icl-rocketry/Ricardo-ThrottleController/README.md

# C.H.A.D - Servo Control Board
2 servo channels controlled by PWM, with a buck converter set to output 6V or 8.4V @ 12A depending on configuration.
