icl-rocketry/Ricardo-ThrottleController/Hardware/3D/Chad.step

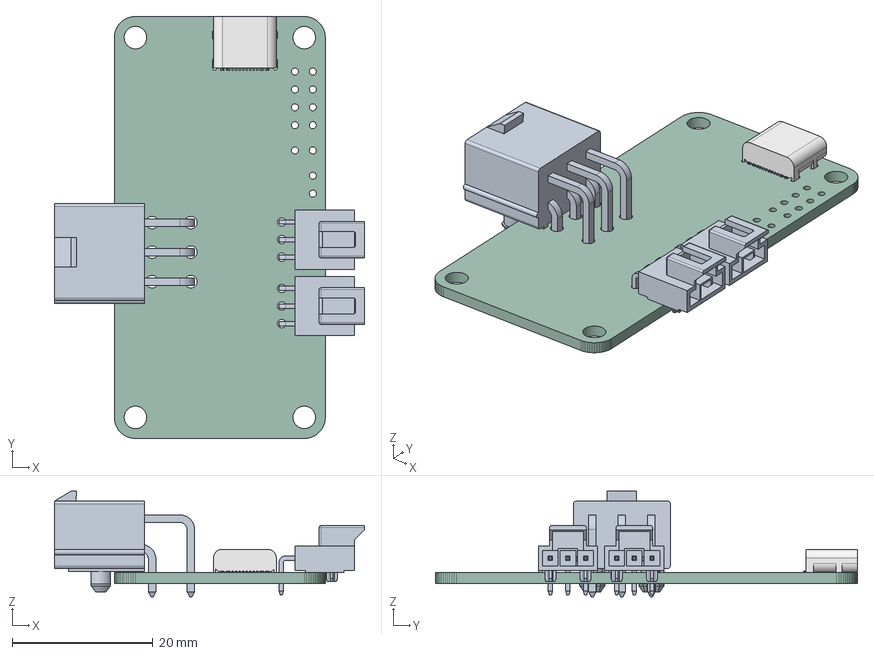
[picture p1: CAD file, 2023-02-25, last stored version]
Hardware/3D/Chad.step
44.1 x 60.0 x 15.0 mm
PCB
