icl-rocketry/Ricardo-ThrottleController/Hardware/Chad.kicad_pcb

## KiCad design Hardware/Chad.kicad_pcb (2023-07-09, last stored version)

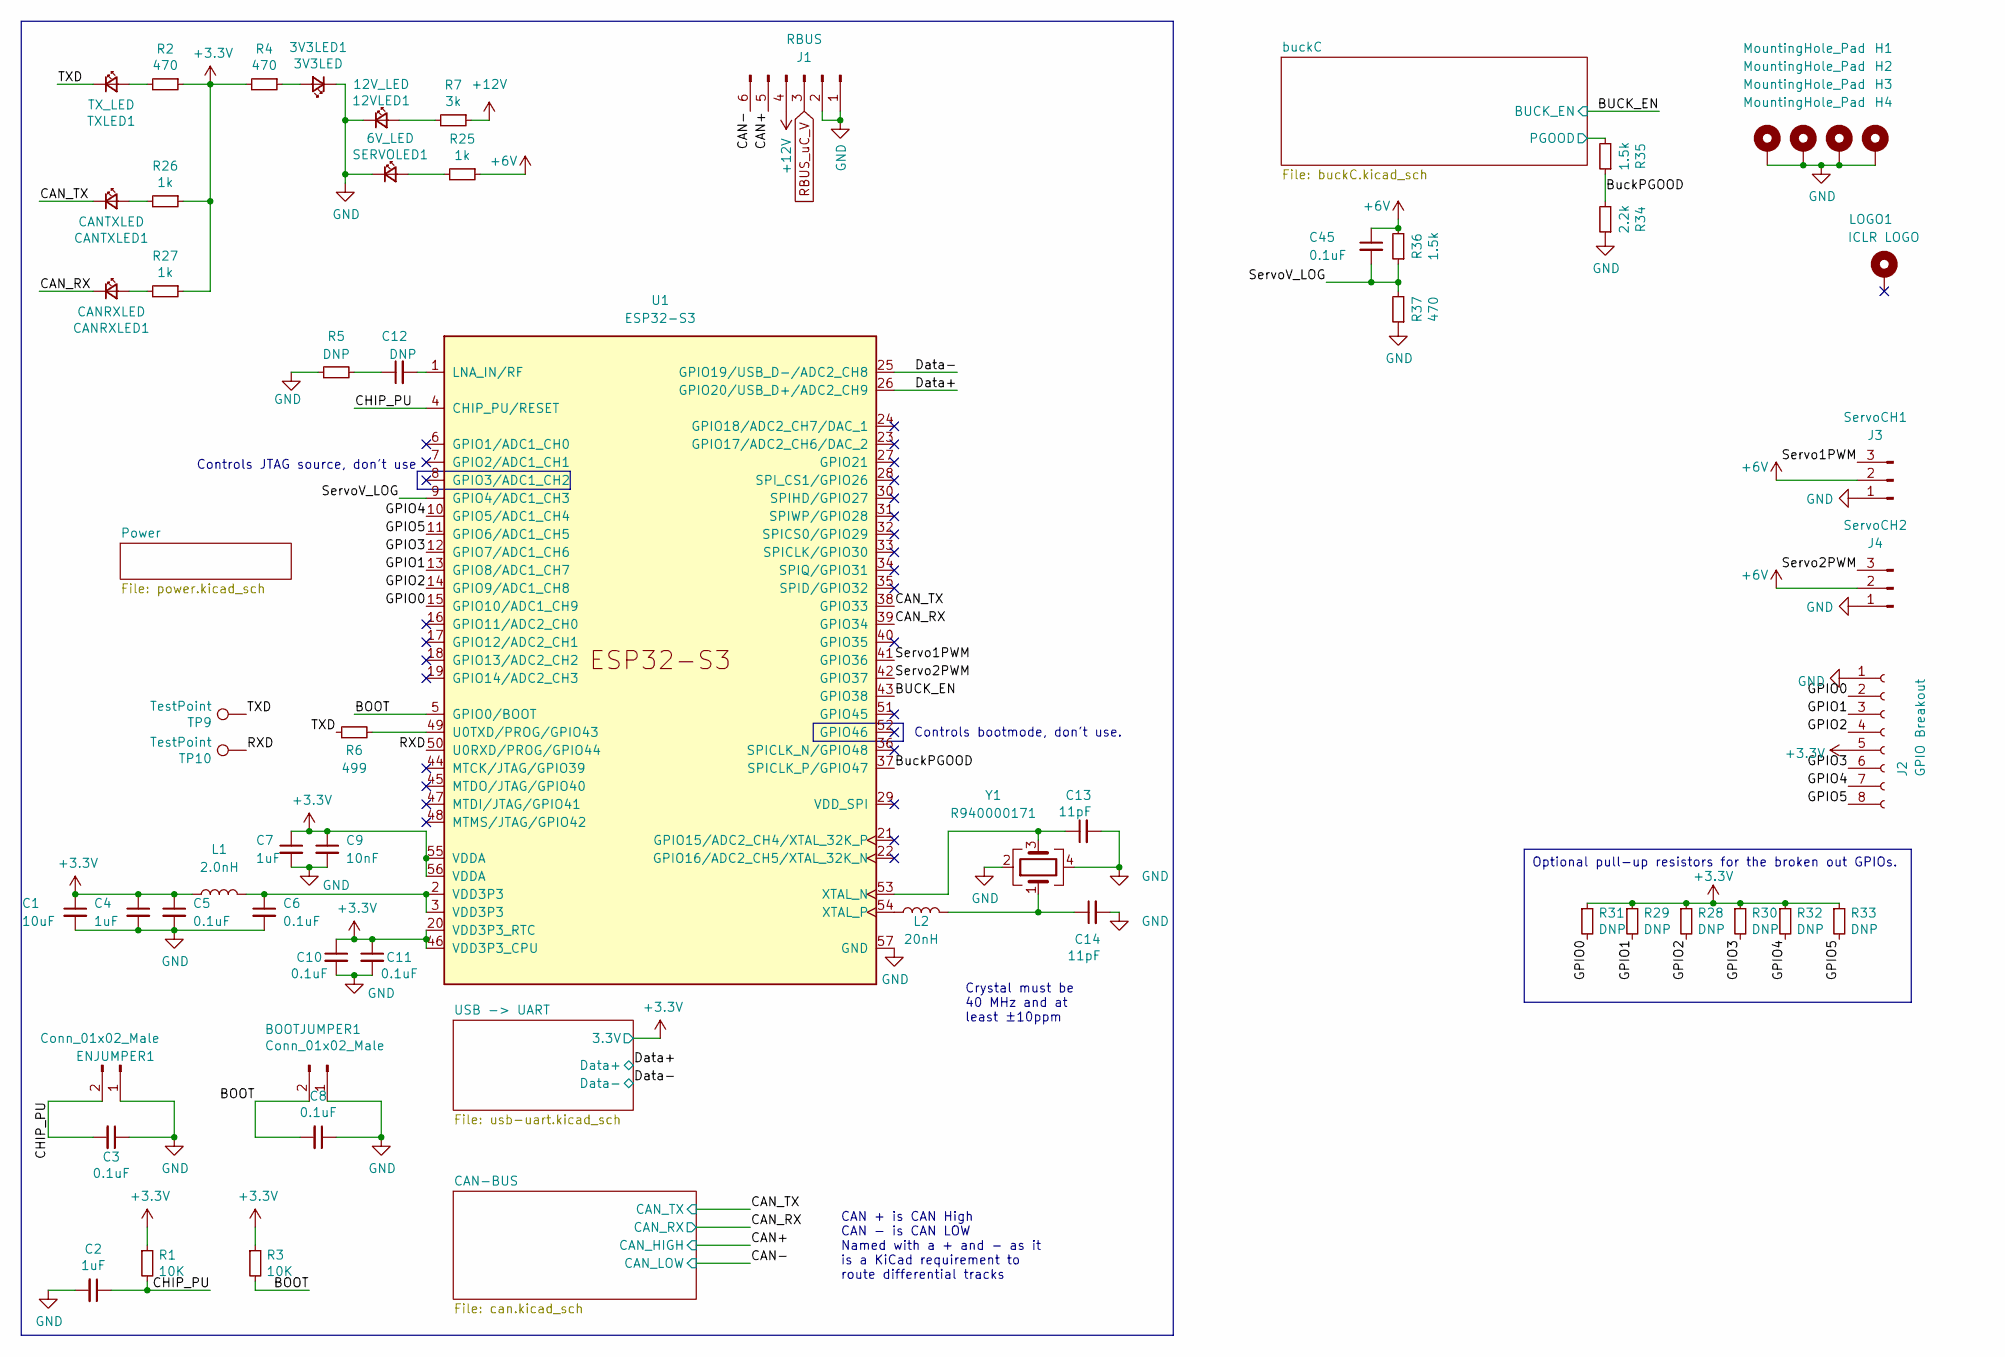
[picture p2: schematic Chad.kicad_sch, C.H.A.D]

Parts:
3V3LED1: 3V3LED; LED_0402_1005Metric
12VLED1: 12V_LED; LED_0402_1005Metric
BOOTJUMPER1: Conn_01x02_Male; PinHeader_1x02_P2.54mm_Vertical
C1: 10uF; C_0402_1005Metric
C2, C4, C7: 1uF; C_0402_1005Metric
C3, C5, C6, C8, C10, C11, C45: 0.1uF; C_0402_1005Metric
C9: 10nF; C_0402_1005Metric
C12: DNP; C_0402_1005Metric
C13, C14: 11pF; C_0402_1005Metric
CANRXLED1: CANRXLED; LED_0402_1005Metric
CANTXLED1: CANTXLED; LED_0402_1005Metric
ENJUMPER1: Conn_01x02_Male; PinHeader_1x02_P2.54mm_Vertical
H1, H2, H3, H4: MountingHole_Pad; MountingHole_3.2mm_M3_DIN965_Pad
J1: RBUS; Molex_Mini-Fit_Jr_5569-06A2_2x03_P4.20mm_Horizontal
J2: GPIO Breakout; PinSocket_2x04_P2.54mm_Vertical
J3: ServoCH1; Molex_Nano-Fit_105313-xx03_1x03_P2.50mm_Horizontal
J4: ServoCH2; Molex_Nano-Fit_105313-xx03_1x03_P2.50mm_Horizontal
L1: 2.0nH; L_0402_1005Metric
L2: 20nH; L_0402_1005Metric
LOGO1: ICLR LOGO; iclr_logo_estd2018_10mm
R1, R3: 10K; R_0402_1005Metric
R2, R4, R37: 470; R_0402_1005Metric
R5, R28, R29, R30, R31, R32, R33: DNP; R_0402_1005Metric
R6: 499; R_0402_1005Metric
R7: 3k; R_0402_1005Metric
R25, R26, R27: 1k; R_0402_1005Metric
R34: 2.2k; R_0402_1005Metric
R35, R36: 1.5k; R_0402_1005Metric
SERVOLED1: 6V_LED; LED_0402_1005Metric
TP9, TP10: TestPoint; TestPoint_Pad_D1.0mm
TXLED1: TX_LED; LED_0402_1005Metric
U1: ESP32-S3; QFN40P700X700X90-57N
Y1: R940000171; Crystal_SMD_2016-4Pin_2.0x1.6mm

Connections:
+3V3: C1.1, C4.1, C5.1, C7.1, C9.1, C10.1, C11.1, J2.5, L1.1, R1.1, R2.1, R3.1, R4.2, R26.1, R27.1, R28.1, R29.1, R30.1, R31.1, R32.1, R33.1, U1.20 (VDD3P3_RTC), U1.46 (VDD3P3_CPU), U1.55 (VDDA), U1.56 (VDDA); also elsewhere on the board
+6V: C45.1, J3.2, J4.2, R25.1, R36.2; also elsewhere on the board
+12V: J1.4, R7.1; also elsewhere on the board
/BOOT: BOOTJUMPER1.2, C8.2, R3.2, U1.5 (GPIO0/BOOT)
/BUCK_EN: U1.43 (GPIO38); also elsewhere on the board
/BuckPGOOD: R34.2, R35.1, U1.37 (SPICLK_P/GPIO47)
/CAN+: J1.5; also elsewhere on the board
/CAN-: J1.6; also elsewhere on the board
/CAN_RX: CANRXLED1.1 (K), U1.39 (GPIO34); also elsewhere on the board
/CAN_TX: CANTXLED1.1 (K), U1.38 (GPIO33); also elsewhere on the board
/CHIP_PU: C2.1, C3.2, ENJUMPER1.2, R1.2, U1.4 (CHIP_PU/RESET)
/Data+: U1.26 (GPIO20/USB_D+/ADC2_CH9); also elsewhere on the board
/Data-: U1.25 (GPIO19/USB_D-/ADC2_CH8); also elsewhere on the board
/GPIO0: J2.2, R31.2, U1.15 (GPIO10/ADC1_CH9)
/GPIO1: J2.3, R29.2, U1.13 (GPIO8/ADC1_CH7)
/GPIO2: J2.4, R28.2, U1.14 (GPIO9/ADC1_CH8)
/GPIO3: J2.6, R30.2, U1.12 (GPIO7/ADC1_CH6)
/GPIO4: J2.7, R32.2, U1.10 (GPIO5/ADC1_CH4)
/GPIO5: J2.8, R33.2, U1.11 (GPIO6/ADC1_CH5)
/RXD: TP10.1, U1.50 (U0RXD/PROG/GPIO44)
/Servo1PWM: J3.3, U1.41 (GPIO36)
/Servo2PWM: J4.3, U1.42 (GPIO37)
/ServoV_LOG: C45.2, R36.1, R37.2, U1.9 (GPIO4/ADC1_CH3)
/TXD: R6.1, TP9.1, TXLED1.1 (K)
/buckC/PGOOD: R35.2; also elsewhere on the board
GND: 3V3LED1.1 (K), 12VLED1.1 (K), BOOTJUMPER1.1, C1.2, C2.2, C3.1, C4.2, C5.2, C6.2, C7.2, C8.1, C9.2, C10.2, C11.2, C13.2, C14.2, ENJUMPER1.1, H1.1, H2.1, H3.1, H4.1, J1.1, J1.2, J2.1, J3.1, J4.1, R5.1, R34.1, R37.1, SERVOLED1.1 (K), U1.57 (GND), Y1.2, Y1.4; also elsewhere on the board
unnamed: 3V3LED1.2 (A), R4.1
unnamed: 12VLED1.2 (A), R7.2
unnamed: C6.1, L1.2, U1.2 (VDD3P3), U1.3 (VDD3P3)
unnamed: C12.1, R5.2
unnamed: C14.1, L2.2, Y1.1
unnamed: CANRXLED1.2 (A), R27.2
unnamed: CANTXLED1.2 (A), R26.2
unnamed: R25.2, SERVOLED1.2 (A)
unnamed: R2.2, TXLED1.2 (A)
unnamed: C12.2, U1.1 (LNA_IN/RF)
unnamed: R6.2, U1.49 (U0TXD/PROG/GPIO43)
unnamed: C13.1, U1.53 (XTAL_N), Y1.3
unnamed: L2.1, U1.54 (XTAL_P)
RBUS_uC_V: J1.3; also elsewhere on the board

Notes on the sheet:
Crystal must be 40 MHz and at least ±10ppm
Optional pull-up resistors for the broken out GPIOs.
Controls bootmode, don't use.
CAN + is CAN High CAN - is CAN LOW Named with a + and - as it is a KiCad requirement to route differential tracks
Controls JTAG source, don't use

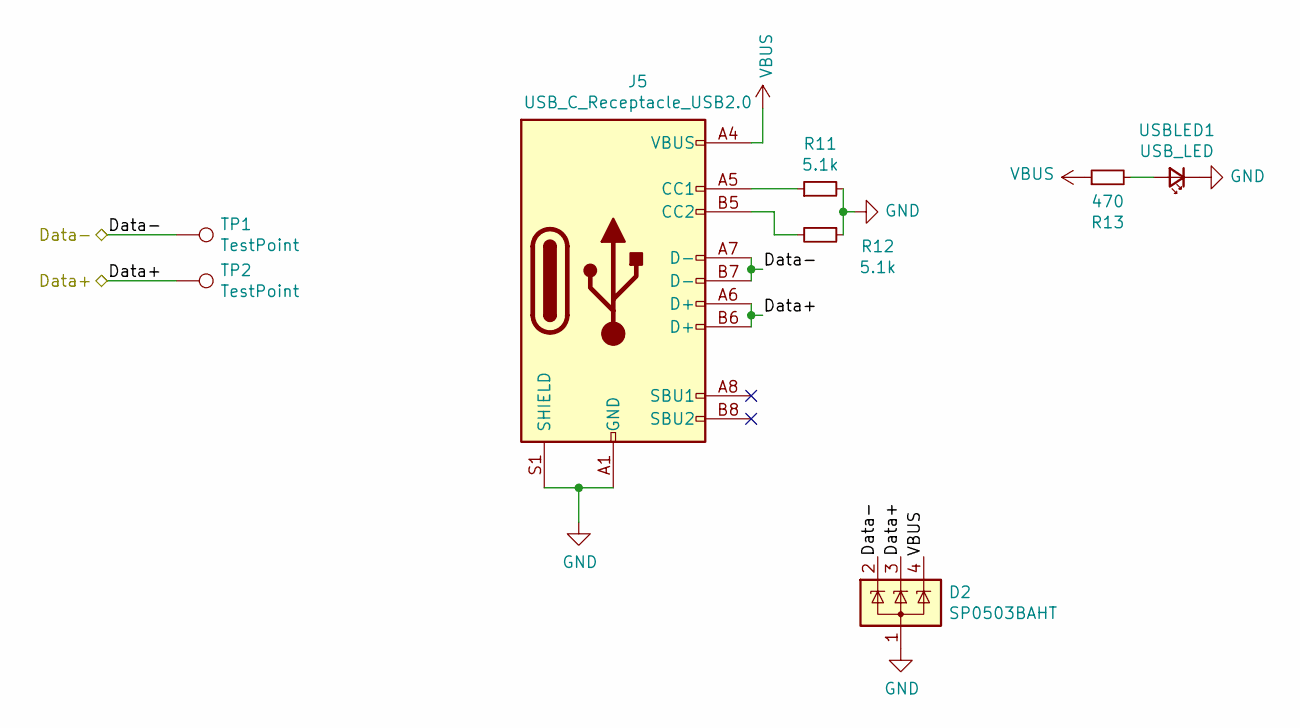
[picture p3: schematic usb-uart.kicad_sch]

Parts:
D2: SP0503BAHT; SOT-143
J5: USB_C_Receptacle_USB2.0; USB_C_Receptacle_Palconn_UTC16-G
R11, R12: 5.1k; R_0402_1005Metric
R13: 470; R_0402_1005Metric
TP1, TP2: TestPoint; TestPoint_Pad_D1.0mm
USBLED1: USB_LED; LED_0402_1005Metric

Connections:
/Data+: D2.3 (K), J5.A6 (D+), J5.B6 (D+), TP2.1; also elsewhere on the board
/Data-: D2.2 (K), J5.A7 (D-), J5.B7 (D-), TP1.1; also elsewhere on the board
GND: D2.1 (A), J5.A1 (GND), J5.A12 (GND), J5.B1 (GND), J5.B12 (GND), J5.S1 (SHIELD), R11.2, R12.1, USBLED1.1 (K); also elsewhere on the board
unnamed: J5.A5 (CC1), R11.1
unnamed: J5.B5 (CC2), R12.2
unnamed: R13.2, USBLED1.2 (A)
VBUS: D2.4 (K), J5.A4 (VBUS), J5.A9 (VBUS), J5.B4 (VBUS), J5.B9 (VBUS), R13.1; also elsewhere on the board

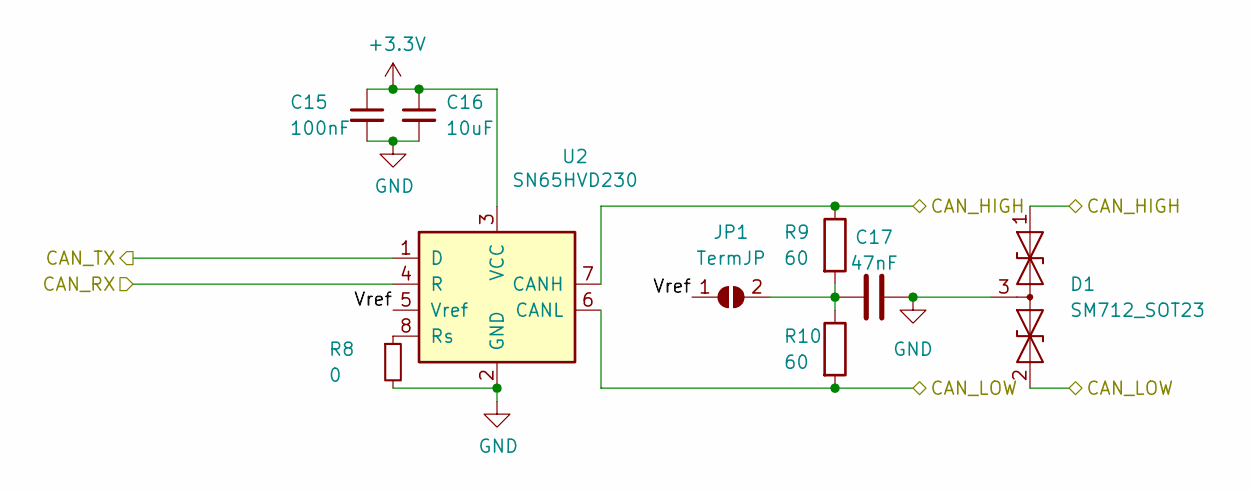
[picture p4: schematic can.kicad_sch]

Parts:
C15: 100nF; C_0402_1005Metric
C16: 10uF; C_0402_1005Metric
C17: 47nF; C_0402_1005Metric
D1: SM712_SOT23; SOT-23
JP1: TermJP; SmallerSolderJP
R8: 0; R_0603_1608Metric
R9, R10: 60; R_0603_1608Metric
U2: SN65HVD230; SOIC-8_3.9x4.9mm_P1.27mm

Connections:
+3V3: C15.1, C16.1, U2.3 (VCC); also elsewhere on the board
/CAN+: D1.1 (A1), R9.1, U2.7 (CANH); also elsewhere on the board
/CAN-: D1.2 (A2), R10.2, U2.6 (CANL); also elsewhere on the board
/CAN-BUS/Vref: JP1.1 (A), U2.5 (Vref)
/CAN_RX: U2.4 (R); also elsewhere on the board
/CAN_TX: U2.1 (D); also elsewhere on the board
GND: C15.2, C16.2, C17.2, D1.3 (common), R8.2, U2.2 (GND); also elsewhere on the board
unnamed: C17.1, JP1.2 (B), R9.2, R10.1
unnamed: R8.1, U2.8 (Rs)

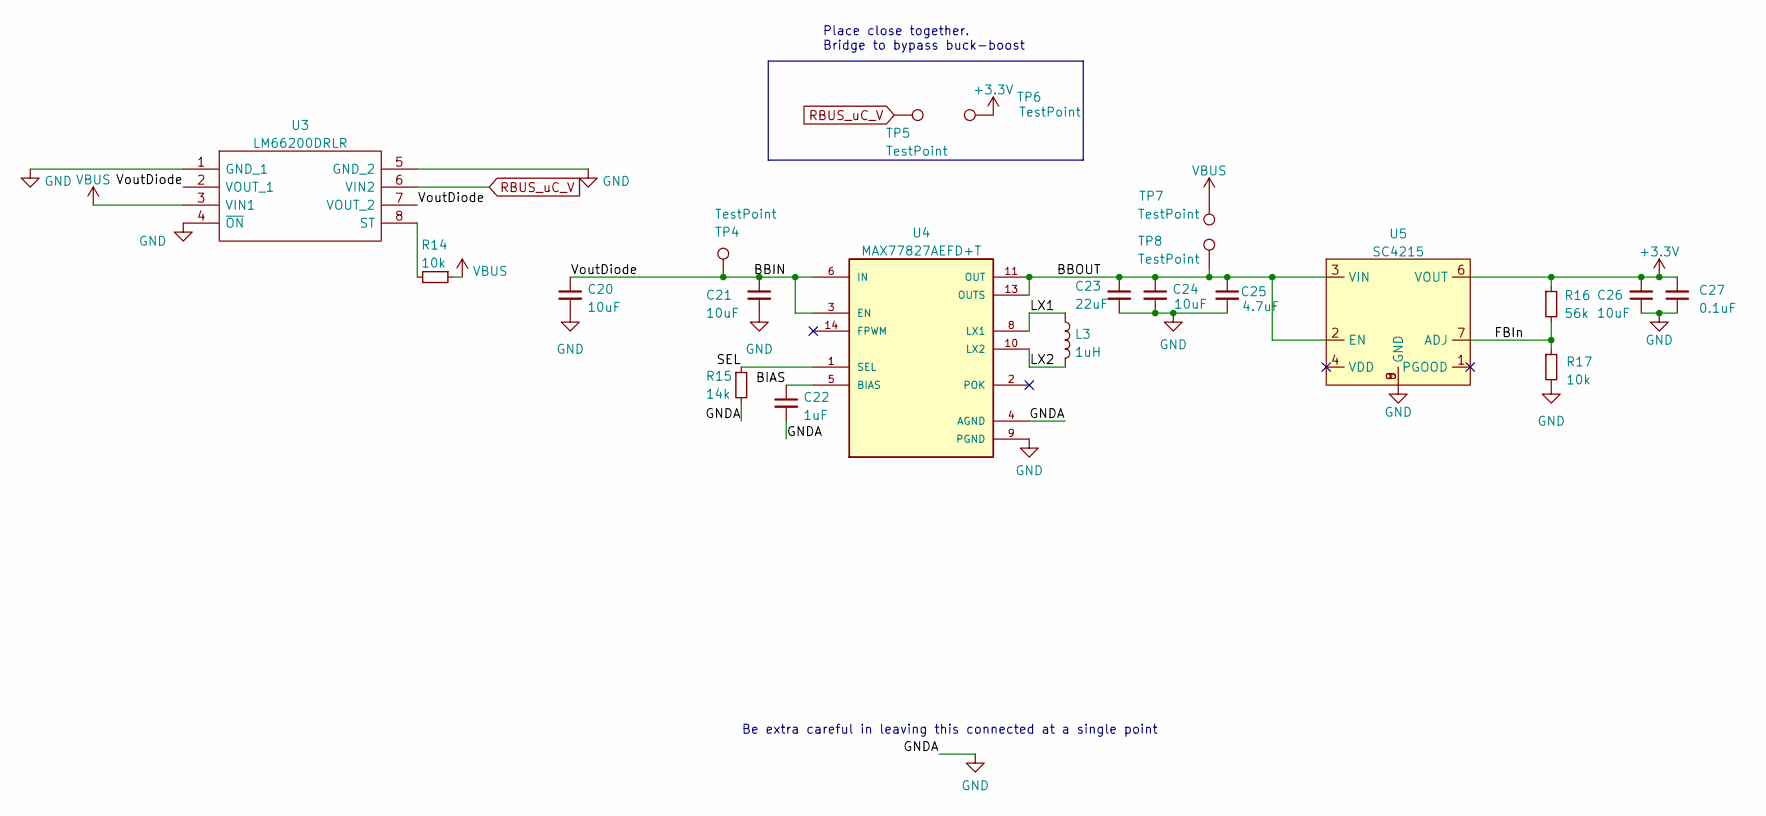
[picture p5: schematic power.kicad_sch]

Parts:
C20, C24, C26: 10uF; C_0402_1005Metric
C21: 10uF; C_0603_1608Metric
C22: 1uF; C_0402_1005Metric
C23: 22uF; C_0603_1608Metric
C25: 4.7uF; C_0402_1005Metric
C27: 0.1uF; C_0402_1005Metric
L3: 1uH; L_0805_2012Metric
R14, R17: 10k; R_0402_1005Metric
R15: 14k; R_0402_1005Metric
R16: 56k; R_0402_1005Metric
TP4, TP5, TP6, TP7, TP8: TestPoint; TestPoint_Pad_D1.5mm
U3: LM66200DRLR; SOTFL50P160X60-8N; Manufacturer_Part_Number LM66200DRLR; Mouser Part Number 595-LM66200DRLR
U4: MAX77827AEFD+T; CONV_MAX77827AEFD+T; PARTREV B
U5: SC4215; SOIC127P599X175-9N

Connections:
+3V3: C26.2, C27.2, R16.1, TP6.1, U5.6 (VOUT); also elsewhere on the board
/Power/BBIN: C20.1, C21.1, TP4.1, U3.2 (VOUT_1), U3.7 (VOUT_2), U4.3 (EN), U4.6 (IN)
/Power/BBOUT: C23.1, C24.1, C25.1, TP8.1, U4.11 (OUT), U4.13 (OUTS), U5.2 (EN), U5.3 (VIN)
/Power/BIAS: C22.1, U4.5 (BIAS)
/Power/FBIn: R16.2, R17.1, U5.7 (ADJ)
/Power/LX1: L3.1, U4.8 (LX1)
/Power/LX2: L3.2, U4.10 (LX2)
/Power/SEL: R15.1, U4.1 (SEL)
GND: C20.2, C21.2, C22.2, C23.2, C24.2, C25.2, C26.1, C27.1, R15.2, R17.2, U3.1 (GND_1), U3.4 (~ON), U3.5 (GND_2), U4.4 (AGND), U4.9 (PGND), U5.8 (GND), U5.9 (GND); also elsewhere on the board
unnamed: R14.2, U3.8 (ST)
RBUS_uC_V: TP5.1, U3.6 (VIN2); also elsewhere on the board
VBUS: R14.1, TP7.1, U3.3 (VIN1); also elsewhere on the board

Notes on the sheet:
Place close together. Bridge to bypass buck-boost
Be extra careful in leaving this connected at a single point

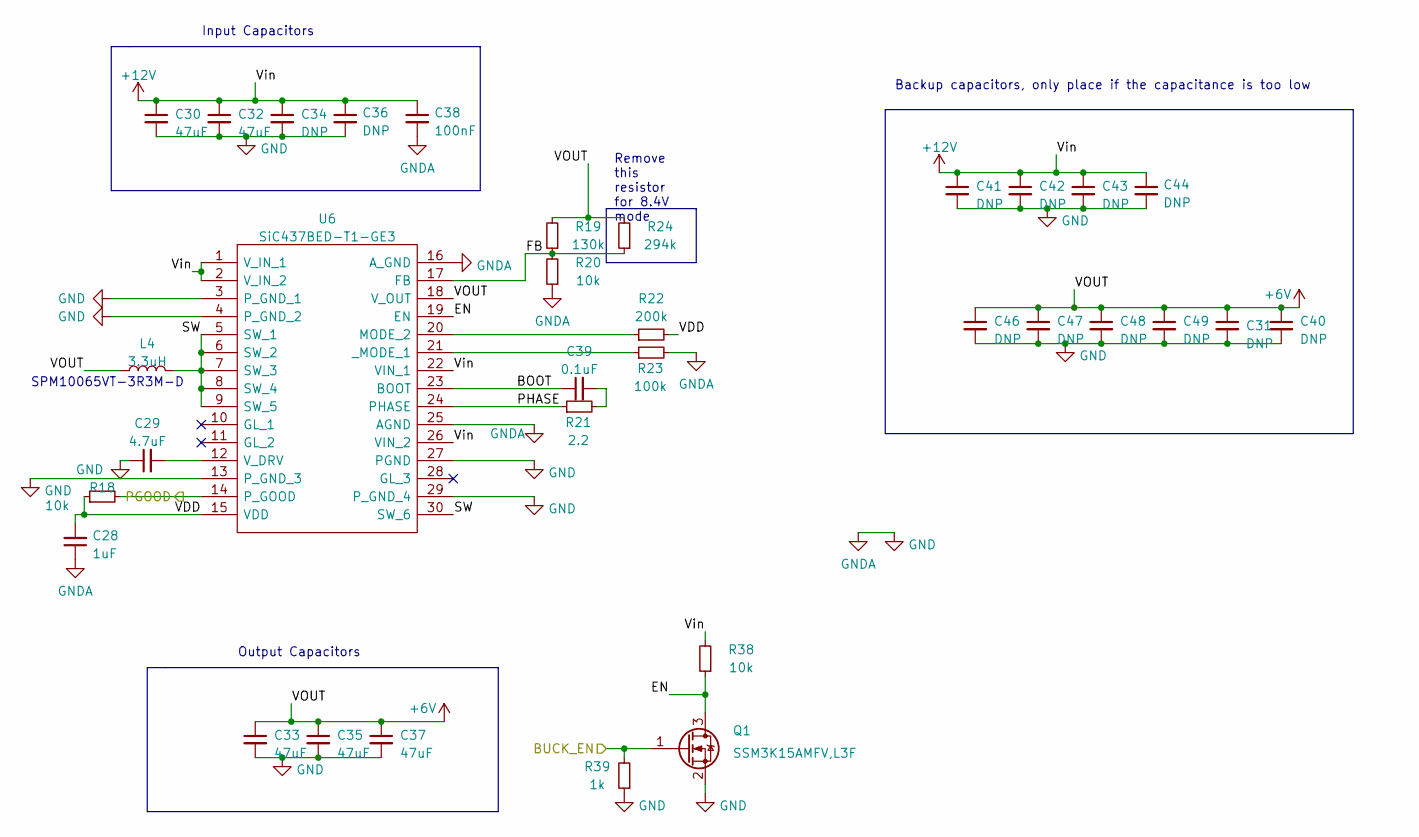
[picture p6: schematic buckC.kicad_sch]

Parts:
C28: 1uF; C_0402_1005Metric
C29: 4.7uF; C_0402_1005Metric
C30, C32, C33, C35, C37: 47uF; C_1206_3216Metric
C31, C34, C36, C40, C41, C42, C43, C44, C47, C49: DNP; C_1206_3216Metric
C38: 100nF; C_0402_1005Metric
C39: 0.1uF; C_0402_1005Metric
C46, C48: DNP; C_0805_2012Metric
L4: 3.3uH; IND_SPM10065VT-3R3M-D
Q1: SSM3K15AMFV,L3F; SOT-723
R18, R20, R38: 10k; R_0402_1005Metric
R19: 130k; R_0402_1005Metric
R21: 2.2; R_0402_1005Metric
R22: 200k; R_0402_1005Metric
R23: 100k; R_0402_1005Metric
R24: 294k; R_0402_1005Metric
R39: 1k; R_0402_1005Metric
U6: SiC437BED-T1-GE3; SiC437BEDT1GE3; Manufacturer_Part_Number SiC437BED-T1-GE3; Mouser Part Number 78-SIC437BED-T1-GE3

Connections:
+6V: C31.1, C33.1, C35.1, C37.1, C40.1, C46.1, C47.1, C48.1, C49.1, L4.1, R19.2, R24.2, U6.18 (V_OUT); also elsewhere on the board
+12V: C30.1, C32.1, C34.1, C36.1, C38.1, C41.1, C42.1, C43.1, C44.1, R38.2, U6.1 (V_IN_1), U6.2 (V_IN_2), U6.22 (VIN_1), U6.26 (VIN_2); also elsewhere on the board
/BUCK_EN: Q1.1 (G), R39.2; also elsewhere on the board
/buckC/BOOT: C39.1, U6.23 (BOOT)
/buckC/EN: Q1.3 (D), R38.1, U6.19 (EN)
/buckC/FB: R19.1, R20.2, R24.1, U6.17 (FB)
/buckC/PGOOD: R18.2, U6.14 (P_GOOD); also elsewhere on the board
/buckC/PHASE: R21.1, U6.24 (PHASE)
/buckC/SW: L4.2, U6.5 (SW_1), U6.6 (SW_2), U6.7 (SW_3), U6.8 (SW_4), U6.9 (SW_5), U6.30 (SW_6)
/buckC/VDD: C28.2, R18.1, R22.2, U6.15 (VDD)
GND: C28.1, C29.1, C30.2, C31.2, C32.2, C33.2, C34.2, C35.2, C36.2, C37.2, C38.2, C40.2, C41.2, C42.2, C43.2, C44.2, C46.2, C47.2, C48.2, C49.2, Q1.2 (S), R20.1, R23.2, R39.1, U6.3 (P_GND_1), U6.4 (P_GND_2), U6.13 (P_GND_3), U6.16 (A_GND), U6.25 (AGND), U6.27 (PGND), U6.29 (P_GND_4); also elsewhere on the board
unnamed: C39.2, R21.2
unnamed: R22.1, U6.20 (MODE_2)
unnamed: C29.2, U6.12 (V_DRV)
unnamed: R23.1, U6.21 (_MODE_1)

Notes on the sheet:
Remove this resistor for 8.4V mode
Backup capacitors, only place if the capacitance is too low
SPM10065VT-3R3M-D
Input Capacitors
Output Capacitors

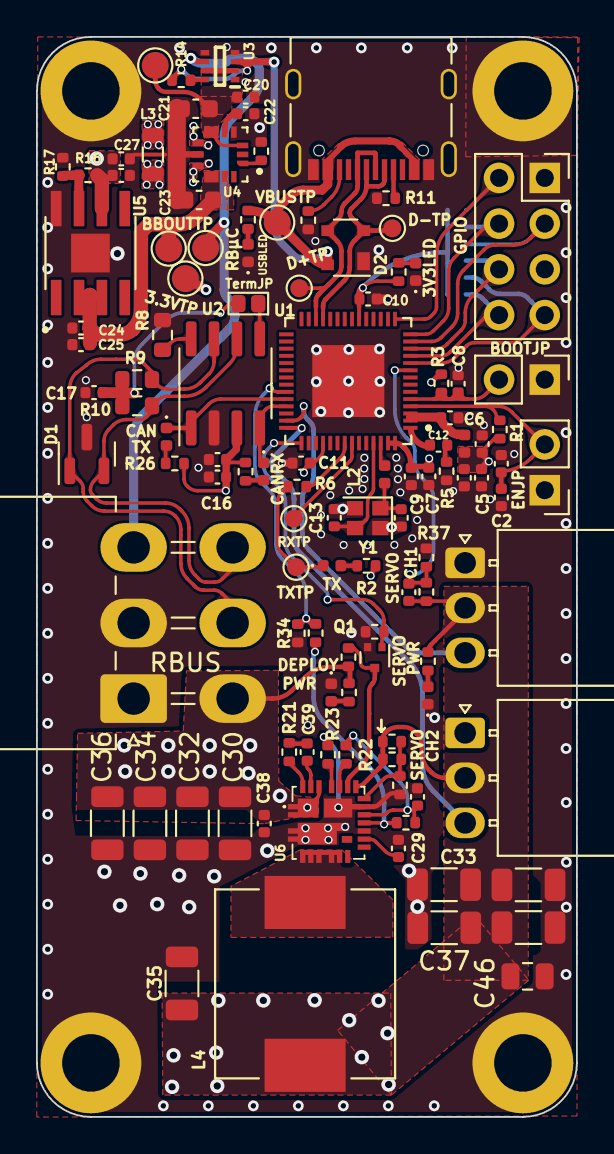
[picture p7: board Chad.kicad_pcb from above]

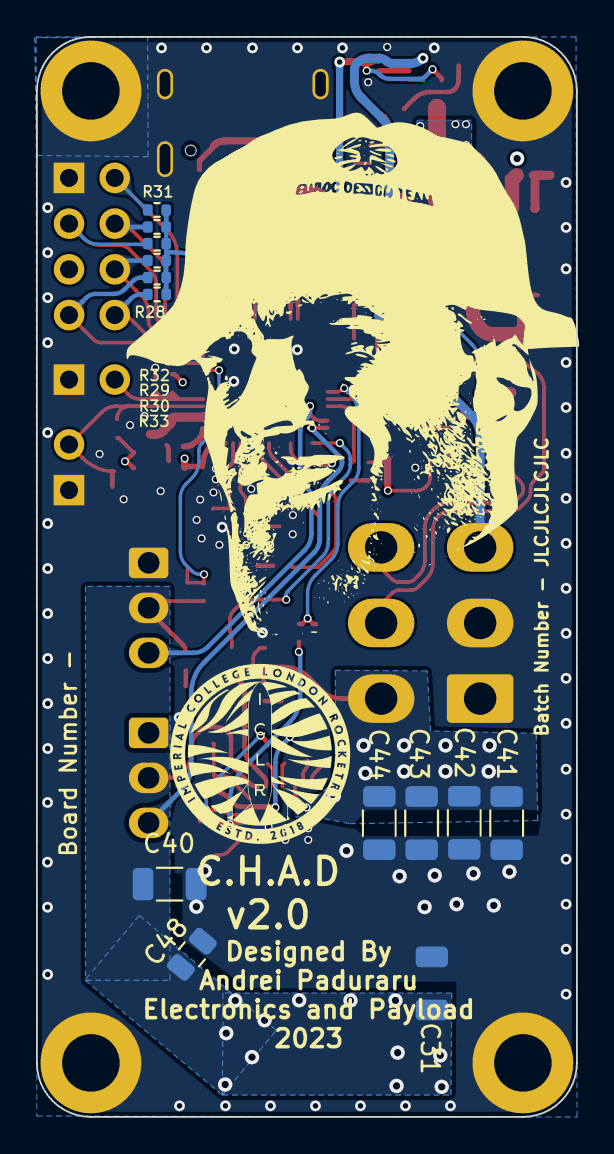
[picture p8: board Chad.kicad_pcb from below]

Board: 4 copper layers, 30.0 x 60.0 mm, 129 parts (14 on the bottom side), 65 nets.
