icl-rocketry/Ricardo-ThrottleController/Powerboard/powerboard_sc21_as25.kicad_pcb

## KiCad design Powerboard/powerboard_sc21_as25.kicad_pcb (2022-07-02, last stored version)

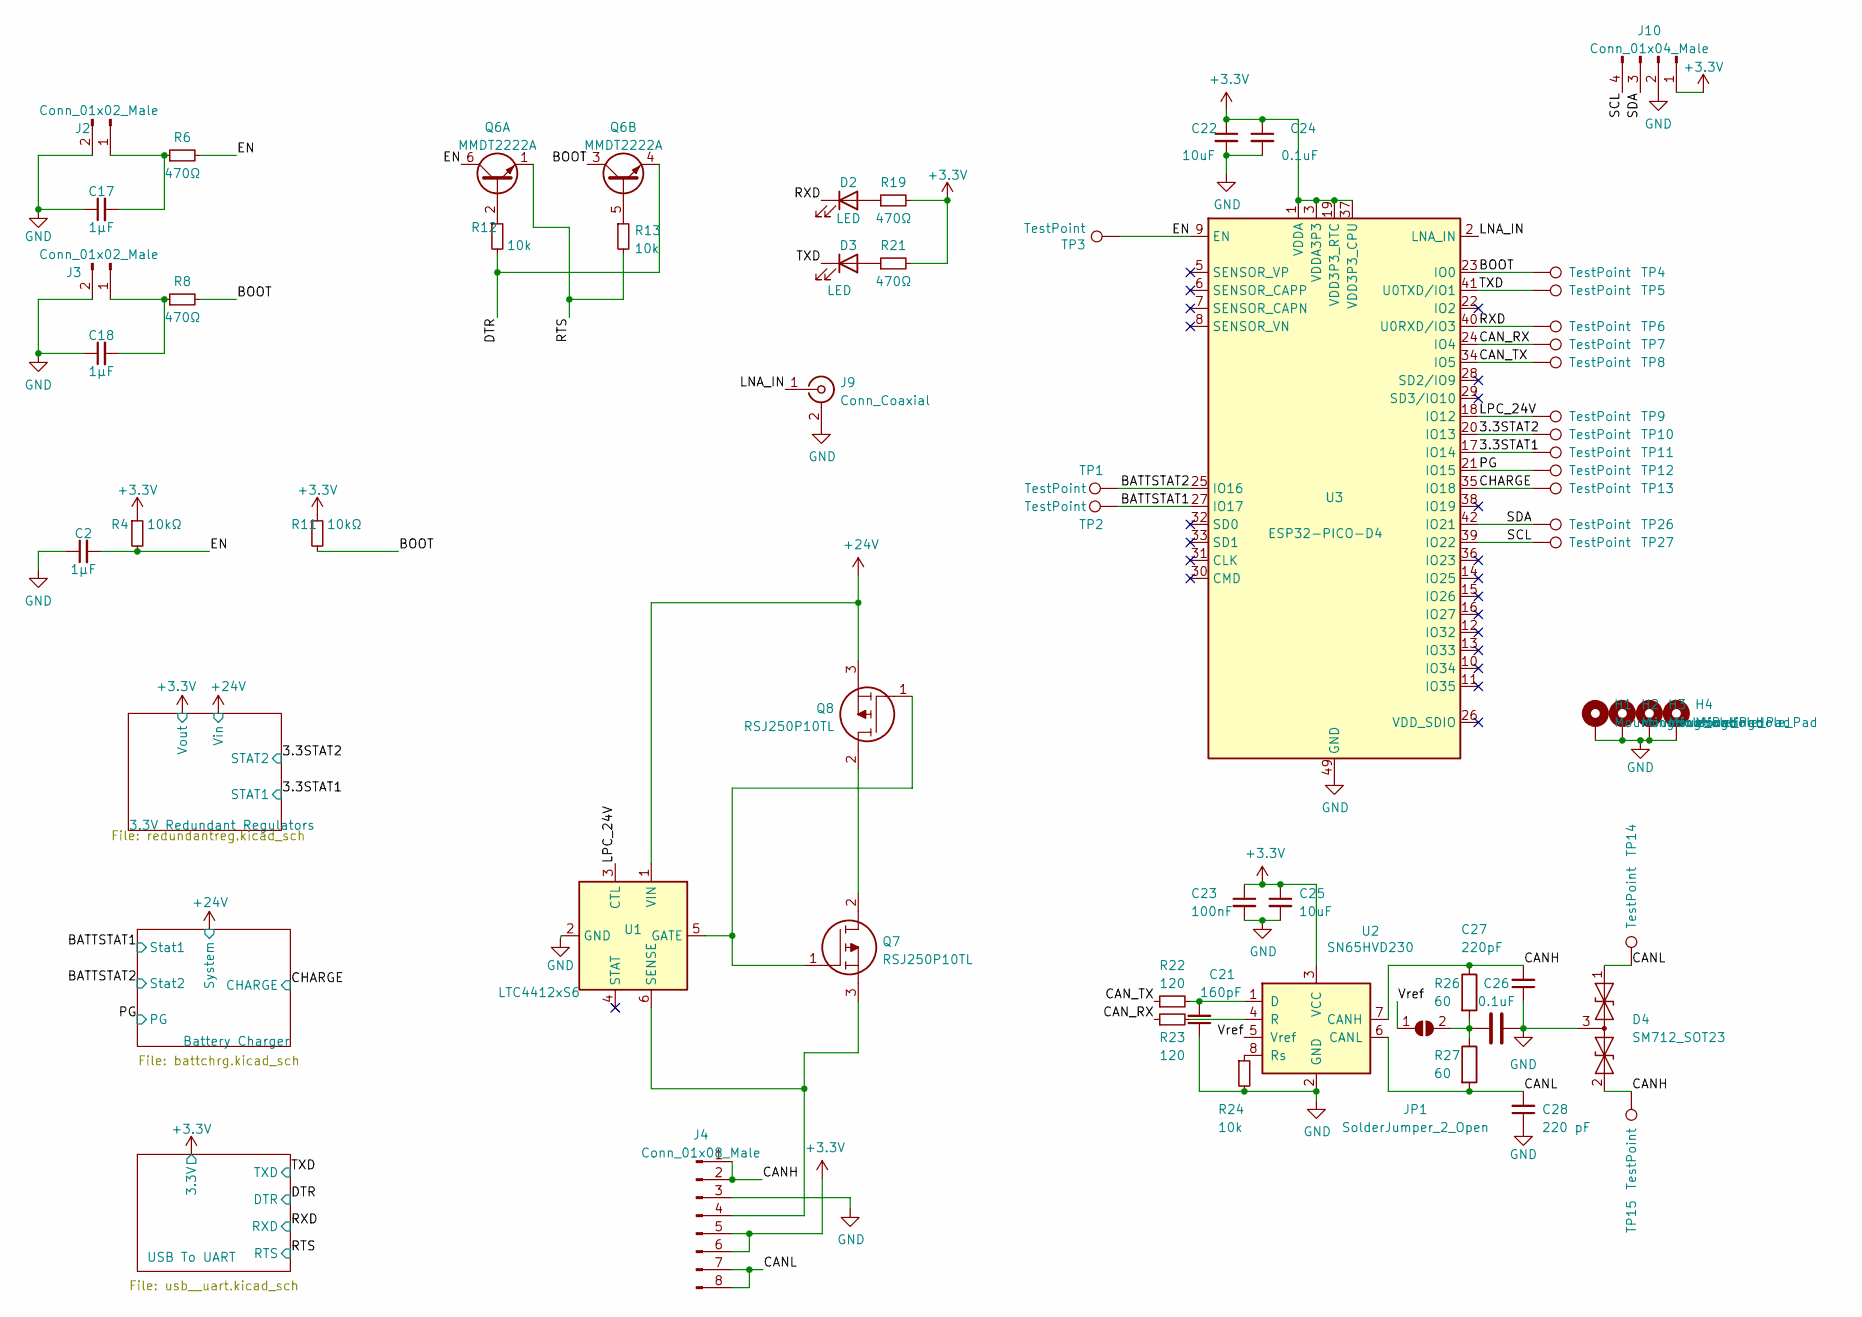
[picture p10: schematic powerboard_sc21_as25.kicad_sch]

Parts:
C2, C17, C18: 1μF; C_0603_1608Metric
C21: 160pF; C_0603_1608Metric
C22, C25: 10uF; C_0805_2012Metric
C23: 100nF; C_0603_1608Metric
C24, C26: 0.1uF; C_0603_1608Metric
C27: 220pF; C_0603_1608Metric
C28: 220 pF; C_0603_1608Metric
D2, D3: LED; LED_0603_1608Metric
D4: SM712_SOT23; SOT-23
H1, H2, H3, H4: MountingHole_Pad; MountingHole_3.2mm_M3_DIN965_Pad
J2, J3: Conn_01x02_Male; PinHeader_1x02_P2.54mm_Vertical
J4: Conn_01x08_Male; Molex_Mini-Fit_Jr_5566-08A_2x04_P4.20mm_Vertical
J9: Conn_Coaxial; U.FL_Molex_MCRF_73412-0110_Vertical
J10: Conn_01x04_Male; JST_XH_B4B-XH-AM_1x04_P2.50mm_Vertical
JP1: SolderJumper_2_Open; SolderJumper-2_P1.3mm_Open_RoundedPad1.0x1.5mm
Q6: MMDT2222A; SOT-363_SC-70-6
Q7, Q8: RSJ250P10TL; TO-263-3_TabPin2; Manufacturer_Part_Number RSJ250P10TL; Mouser Part Number 755-RSJ250P10TL
R4, R11: 10kΩ; R_0603_1608Metric
R6, R8, R19, R21: 470Ω; R_0603_1608Metric
R12, R13, R24: 10k; R_0603_1608Metric
R22, R23: 120; R_0603_1608Metric
R26, R27: 60; R_0603_1608Metric
TP1, TP2, TP3, TP4, TP5, TP6, TP7, TP8, TP9, TP10, TP11, TP12, TP13, TP14, TP15, TP26, TP27: TestPoint; TestPoint_Pad_D1.0mm
U1: LTC4412xS6; TSOT-23-6
U2: SN65HVD230; SOIC-8_3.9x4.9mm_P1.27mm
U3: ESP32-PICO-D4; QFN-48-1EP_7x7mm_P0.5mm_EP5.3x5.3mm

Connections:
+3V3: C22.1, C23.1, C24.1, C25.1, J4.5, J4.6, J10.1, R4.1, R11.1, R19.2, R21.2, U2.3 (VCC), U3.1 (VDDA), U3.3 (VDDA3P3), U3.4 (VDDA3P3), U3.19 (VDD3P3_RTC), U3.37 (VDD3P3_CPU), U3.43 (VDDA), U3.46 (VDDA); also elsewhere on the board
+24V: Q8.3, U1.1 (VIN); also elsewhere on the board
/3.3STAT1: TP11.1, U3.17 (IO14); also elsewhere on the board
/3.3STAT2: TP10.1, U3.20 (IO13); also elsewhere on the board
/BATTSTAT1: TP2.1, U3.27 (IO17); also elsewhere on the board
/BATTSTAT2: TP1.1, U3.25 (IO16); also elsewhere on the board
/BOOT: Q6.3 (C2), R8.2, R11.2, TP4.1, U3.23 (IO0)
/CANH: C27.2, D4.2 (A2), J4.1, J4.2, R26.1, TP15.1, U2.7 (CANH)
/CANL: C28.2, D4.1 (A1), J4.7, J4.8, R27.2, TP14.1, U2.6 (CANL)
/CAN_RX: R23.1, TP7.1, U3.24 (IO4)
/CAN_TX: R22.1, TP8.1, U3.34 (IO5)
/CHARGE: TP13.1, U3.35 (IO18); also elsewhere on the board
/DTR: Q6.4 (E2), R12.2; also elsewhere on the board
/EN: C2.2, Q6.6 (C1), R4.2, R6.2, TP3.1, U3.9 (EN)
/LNA_IN: J9.1 (In), U3.2 (LNA_IN)
/LPC_24V: TP9.1, U1.3 (CTL), U3.18 (IO12)
/PG: TP12.1, U3.21 (IO15); also elsewhere on the board
/RTS: Q6.1 (E1), R13.2; also elsewhere on the board
/RXD: D2.1 (K), TP6.1, U3.40 (U0RXD/IO3); also elsewhere on the board
/SCL: J10.4, TP27.1, U3.39 (IO22)
/SDA: J10.3, TP26.1, U3.42 (IO21)
/TXD: D3.1 (K), TP5.1, U3.41 (U0TXD/IO1); also elsewhere on the board
/Vref: JP1.1 (A), U2.5 (Vref)
GND: C2.1, C17.1, C18.1, C21.1, C22.2, C23.2, C24.2, C25.2, C26.2, C27.1, C28.1, D4.3 (common), H1.1, H2.1, H3.1, H4.1, J2.2, J3.2, J4.3, J9.2 (Ext), J10.2, R24.2, U1.2 (GND), U2.2 (GND), U3.49 (GND); also elsewhere on the board
unnamed: C17.2, J2.1, R6.1
unnamed: C18.2, J3.1, R8.1
unnamed: C21.2, R22.2, U2.1 (D)
unnamed: C26.1, JP1.2 (B), R26.2, R27.1
unnamed: D2.2 (A), R19.1
unnamed: D3.2 (A), R21.1
unnamed: J4.4, Q7.3, U1.6 (SENSE)
unnamed: Q6.2 (B1), R12.1
unnamed: Q6.5 (B2), R13.1
unnamed: Q7.1, Q8.1, U1.5 (GATE)
unnamed: Q7.2, Q8.2
unnamed: R23.2, U2.4 (R)
unnamed: R24.1, U2.8 (Rs)
