icl-rocketry/Ricardo-ThrottleController/Powerboard/powerboard_sc21_as25.kicad_pcb

## KiCad design Powerboard/powerboard_sc21_as25.kicad_pcb (continued)

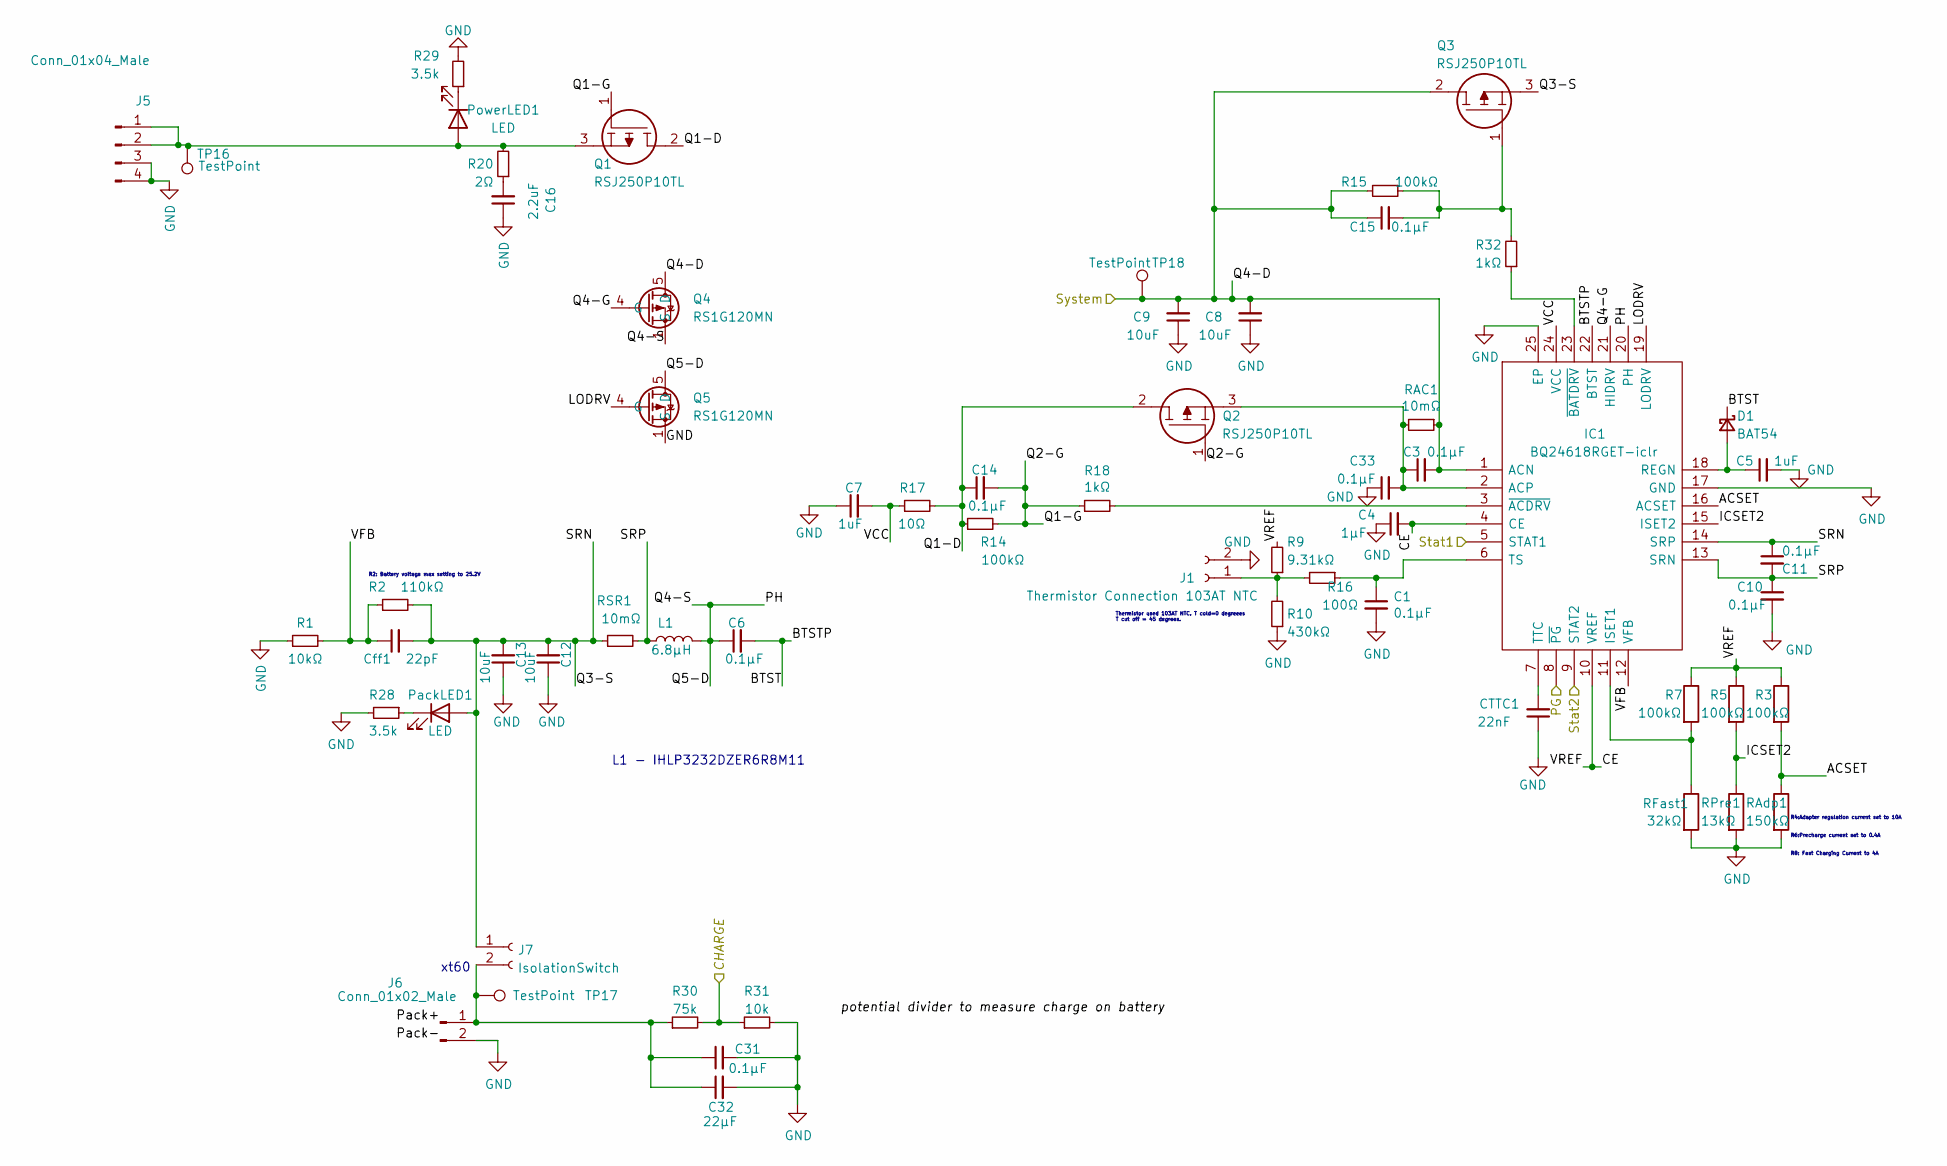
[picture p11: schematic battchrg.kicad_sch]

Parts:
C1, C3, C10, C11, C31, C33: 0.1μF; C_0603_1608Metric
C4: 1μF; C_0603_1608Metric
C5, C7: 1uF; C_0603_1608Metric
C6, C14, C15: 0.1µF; C_0603_1608Metric
C8, C9, C12, C13: 10uF; C_0805_2012Metric
C16: 2.2uF; C_0805_2012Metric
C32: 22μF; C_1210_3225Metric
CTTC1: 22nF; C_0603_1608Metric
Cff1: 22pF; C_0603_1608Metric
D1: BAT54; D_SOT-23_ANK
IC1: BQ24618RGET-iclr; VQFN-24-1EP_4x4mm_P0.5mm_EP2.45x2.45mm; Manufacturer_Part_Number BQ24618RGET; Mouser Part Number 595-BQ24618RGET
J1: Thermistor Connection 103AT NTC; JST_XH_B2B-XH-AM_1x02_P2.50mm_Vertical
J5: Conn_01x04_Male; Molex_Mini-Fit_Jr_5566-04A_2x02_P4.20mm_Vertical
J6: Conn_01x02_Male; AMASS_XT60-M_1x02_P7.20mm_Vertical
J7: IsolationSwitch; AMASS_XT60-M_1x02_P7.20mm_Vertical
L1: 6.8µH; INDM8681X400N
PackLED1: LED; LED_0603_1608Metric
PowerLED1: LED; LED_0603_1608Metric
Q1, Q2, Q3: RSJ250P10TL; TO-263-3_TabPin2; Manufacturer_Part_Number RSJ250P10TL; Mouser Part Number 755-RSJ250P10TL
Q4, Q5: RS1G120MN; HSOP-8-1EP_3.9x4.9mm_P1.27mm_EP2.41x3.1mm
R1: 10kΩ; R_0603_1608Metric
R2: 110kΩ; R_0603_1608Metric
R3, R5, R7, R14, R15: 100kΩ; R_0603_1608Metric
R9: 9.31kΩ; R_0603_1608Metric
R10: 430kΩ; R_0603_1608Metric
R16: 100Ω; R_0603_1608Metric
R17: 10Ω; R_0603_1608Metric
R18, R32: 1kΩ; R_0603_1608Metric
R20: 2Ω; R_0603_1608Metric
R28, R29: 3.5k; R_0603_1608Metric
R30: 75k; R_0603_1608Metric
R31: 10k; R_0603_1608Metric
RAC1: 10mΩ; R_0603_1608Metric
RAdp1: 150kΩ; R_0603_1608Metric
RFast1: 32kΩ; R_0603_1608Metric
RPre1: 13kΩ; R_0603_1608Metric
RSR1: 10mΩ; R_0603_1608Metric
TP16, TP17, TP18: TestPoint; TestPoint_Pad_D1.0mm

Connections:
+24V: C3.2, C8.2, C9.2, C15.1, IC1.1 (ACN), Q3.2, Q4.5 (D), Q4.6 (D), Q4.7 (D), Q4.8 (D), Q4.9 (D), R15.2, RAC1.1, TP18.1; also elsewhere on the board
/BATTSTAT1: IC1.5 (STAT1); also elsewhere on the board
/BATTSTAT2: IC1.9 (STAT2); also elsewhere on the board
/Battery Charger/ACSET: IC1.16 (ACSET), R3.2, RAdp1.1
/Battery Charger/BTST: C6.2, D1.1 (K), IC1.22 (BTST)
/Battery Charger/CE: C4.2, IC1.4 (CE), IC1.10 (VREF), R3.1, R5.1, R7.1, R9.2
/Battery Charger/LODRV: IC1.19 (LODRV), Q5.4 (G)
/Battery Charger/PH: C6.1, IC1.20 (PH), L1.2, Q4.1 (S), Q4.2 (S), Q4.3 (S), Q5.5 (D), Q5.6 (D), Q5.7 (D), Q5.8 (D), Q5.9 (D)
/Battery Charger/Q1-D: C14.1, Q1.2, Q2.2, R14.1, R17.2
/Battery Charger/Q1-G: C14.2, Q1.1, Q2.1, R14.2, R18.1
/Battery Charger/Q3-S: C11.1, C12.2, C13.2, Cff1.2, IC1.14 (SRP), J7.1, PackLED1.2 (A), Q3.3, R2.2, RSR1.1
/Battery Charger/Q4-G: IC1.21 (HIDRV), Q4.4 (G)
/Battery Charger/SRP: C10.1, C11.2, IC1.13 (SRN), L1.1, RSR1.2
/Battery Charger/VCC: C7.2, IC1.24 (VCC), R17.1
/Battery Charger/VFB: Cff1.1, IC1.12 (VFB), R1.2, R2.1
/CHARGE: R30.2, R31.1; also elsewhere on the board
/PG: IC1.8 (~PG); also elsewhere on the board
GND: C1.2, C4.1, C5.2, C7.1, C8.1, C9.1, C10.2, C12.1, C13.1, C16.1, C31.2, C32.2, C33.1, CTTC1.1, IC1.17 (GND), IC1.25 (EP), J1.2, J5.3, J5.4, J6.2, Q5.1 (S), Q5.2 (S), Q5.3 (S), R1.1, R10.1, R28.2, R29.2, R31.2, RAdp1.2, RFast1.2, RPre1.2; also elsewhere on the board
unnamed: C1.1, IC1.6 (TS), R16.1
unnamed: C3.1, C33.2, IC1.2 (ACP), Q2.3, RAC1.2
unnamed: C5.1, D1.2 (A), IC1.18 (REGN)
unnamed: C15.2, Q3.1, R15.1, R32.2
unnamed: C16.2, R20.1
unnamed: C31.1, C32.1, J6.1, J7.2, R30.1, TP17.1
unnamed: CTTC1.2, IC1.7 (TTC)
unnamed: IC1.3 (~ACDRV), R18.2
unnamed: IC1.11 (ISET1), R7.2, RFast1.1
unnamed: IC1.23 (~BATDRV), R32.1
unnamed: J1.1, R9.1, R10.2, R16.2
unnamed: J5.1, J5.2, TP16.1
unnamed: PackLED1.1 (K), R28.1
unnamed: PowerLED1.1 (K), R29.1
unnamed: PowerLED1.2 (A), Q1.3, R20.2

Notes on the sheet:
R2: Battery voltage max setting to 25.2V
R4:Adapter regulation current set to 10A
L1 - IHLP3232DZER6R8M11
R8: Fast Charging Current to 4A
Thermistor used 103AT NTC. T cold=0 degreees T cut off = 45 degrees.
R6:Precharge current set to 0.4A
xt60

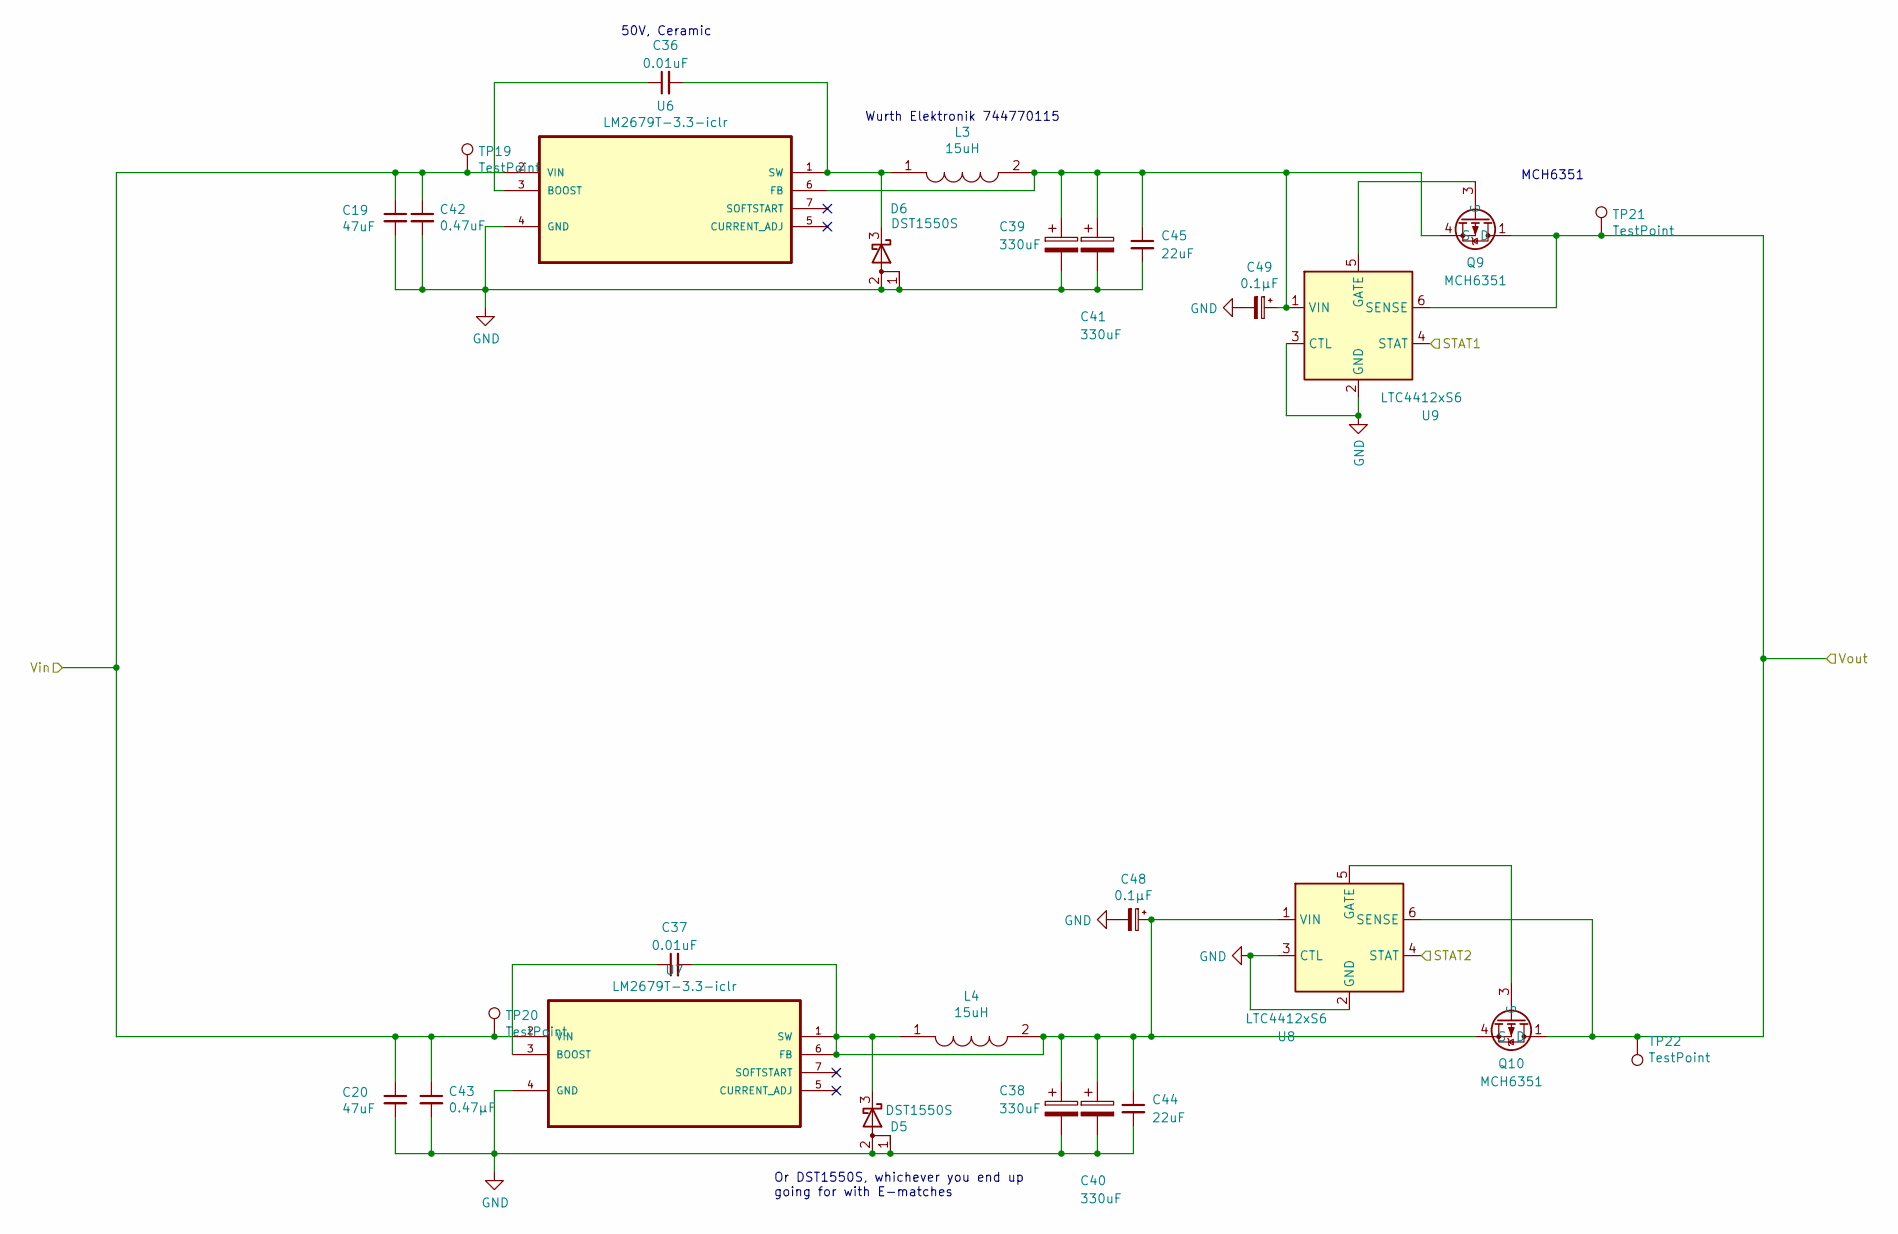
[picture p12: schematic redundantreg.kicad_sch]

Parts:
C19, C20: 47uF; C_2220_5650Metric
C36, C37: 0.01uF; C_0603_1608Metric
C38, C39, C40, C41: 330uF; CP_EIA-7343-30_AVX-N
C42: 0.47uF; C_0805_2012Metric
C43: 0.47μF; C_0805_2012Metric
C44, C45: 22uF; C_0603_1608Metric
C48, C49: 0.1µF; C_0603_1608Metric
D5, D6: DST1550S; TO-277B
L3, L4: 15uH; L_12x12mm_H8mm; Manufacturer_Part_Number P0846SNL; Mouser Part Number 673-P0846SNL
Q9, Q10: MCH6351; SOT-363_SC-70-6
TP19, TP20, TP21, TP22: TestPoint; TestPoint_Pad_D1.0mm
U6, U7: LM2679T-3.3-iclr; TO-263-7_TabPin4; MPN LM2679T-3.3
U8, U9: LTC4412xS6; TSOT-23-6

Connections:
+3V3: Q9.1 (D), Q9.2 (D), Q9.5 (D), Q9.6 (D), Q10.1 (D), Q10.2 (D), Q10.5 (D), Q10.6 (D), TP21.1, TP22.1, U8.6 (SENSE), U9.6 (SENSE); also elsewhere on the board
+24V: C19.1, C20.1, C42.1, C43.1, TP19.1, TP20.1, U6.2 (VIN), U7.2 (VIN); also elsewhere on the board
/3.3STAT1: U9.4 (STAT); also elsewhere on the board
/3.3STAT2: U8.4 (STAT); also elsewhere on the board
GND: C19.2, C20.2, C38.2, C39.2, C40.2, C41.2, C42.2, C43.2, C44.2, C45.2, C48.2, C49.2, D5.1 (A), D5.2 (A), D6.1 (A), D6.2 (A), U6.4 (GND), U7.4 (GND), U8.2 (GND), U8.3 (CTL), U9.2 (GND), U9.3 (CTL); also elsewhere on the board
unnamed: C36.1, U6.3 (BOOST)
unnamed: C36.2, D6.3 (K), L3.1, U6.1 (SW)
unnamed: C37.1, U7.3 (BOOST)
unnamed: C37.2, C38.1, C40.1, C44.1, C48.1, D5.3 (K), L4.1, L4.2, Q10.4 (S), U7.1 (SW), U7.6 (FB), U8.1 (VIN)
unnamed: C39.1, C41.1, C45.1, C49.1, L3.2, Q9.4 (S), U6.6 (FB), U9.1 (VIN)
unnamed: Q9.3 (G), U9.5 (GATE)
unnamed: Q10.3 (G), U8.5 (GATE)

Notes on the sheet:
Wurth Elektronik 744770115
50V, Ceramic
Or DST1550S, whichever you end up going for with E-matches
MCH6351

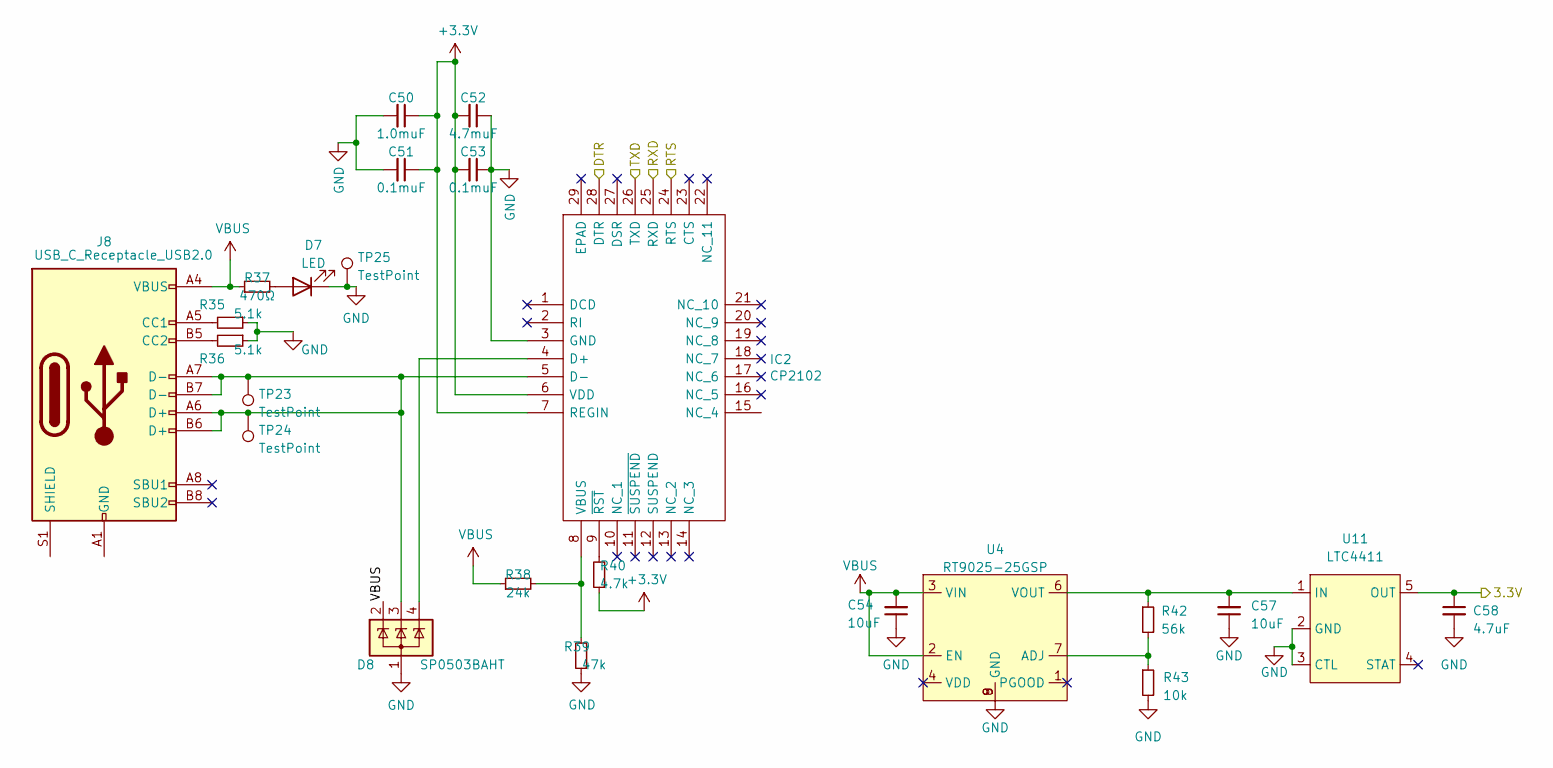
[picture p13: schematic usb__uart.kicad_sch]

Parts:
C50: 1.0muF; C_0603_1608Metric
C51, C53: 0.1muF; C_0603_1608Metric
C52: 4.7muF; C_0603_1608Metric
C54, C57: 10uF; C_0805_2012Metric
C58: 4.7uF; C_0603_1608Metric
D7: LED; LED_0603_1608Metric
D8: SP0503BAHT; SOT-143
IC2: CP2102; QFN28G_0.5-5X5MM; Manufacturer_Part_Number CP2102; Mouser Part Number 634-CP2102
J8: USB_C_Receptacle_USB2.0; USB_C_Receptacle_GCT_USB4085
R35, R36: 5.1k; R_0603_1608Metric
R37: 470Ω; R_0603_1608Metric
R38: 24k; R_0603_1608Metric
R39: 47k; R_0603_1608Metric
R40: 4.7k; R_0603_1608Metric
R42: 56k; R_0603_1608Metric
R43: 10k; R_0603_1608Metric
TP23, TP24, TP25: TestPoint; TestPoint_Pad_D1.0mm
U4: RT9025-25GSP; SOIC127P599X175-9N
U11: LTC4411; SOT-23-5

Connections:
+3V3: C50.1, C51.1, C52.2, C53.2, C58.1, IC2.6 (VDD), IC2.7 (REGIN), R40.1, U11.5 (OUT); also elsewhere on the board
/DTR: IC2.28 (DTR); also elsewhere on the board
/RTS: IC2.24 (RTS); also elsewhere on the board
/RXD: IC2.25 (RXD); also elsewhere on the board
/TXD: IC2.26 (TXD); also elsewhere on the board
GND: C50.2, C51.2, C52.1, C53.1, C54.1, C57.1, C58.2, D7.1 (K), D8.1 (A), IC2.3 (GND), R35.1, R36.1, R39.1, R43.2, TP25.1, U4.8 (GND), U4.9 (GND), U11.2 (GND), U11.3 (CTL); also elsewhere on the board
unnamed: C57.2, R42.1, U4.6 (VOUT), U11.1 (IN)
unnamed: D7.2 (A), R37.2
unnamed: D8.3 (K), IC2.5 (D-), J8.A6 (D+), J8.A7 (D-), J8.B6 (D+), J8.B7 (D-), TP23.1, TP24.1
unnamed: D8.4 (K), IC2.4 (D+)
unnamed: IC2.8 (VBUS), R38.2, R39.2
unnamed: IC2.9 (~RST), R40.2
unnamed: J8.A1 (GND), J8.A12 (GND), J8.B1 (GND), J8.B12 (GND)
unnamed: J8.A5 (CC1), R35.2
unnamed: J8.B5 (CC2), R36.2
unnamed: R42.2, R43.1, U4.7 (ADJ)
VBUS: C54.2, D8.2 (K), J8.A4 (VBUS), J8.A9 (VBUS), J8.B4 (VBUS), J8.B9 (VBUS), R37.1, R38.1, U4.2 (EN), U4.3 (VIN)

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
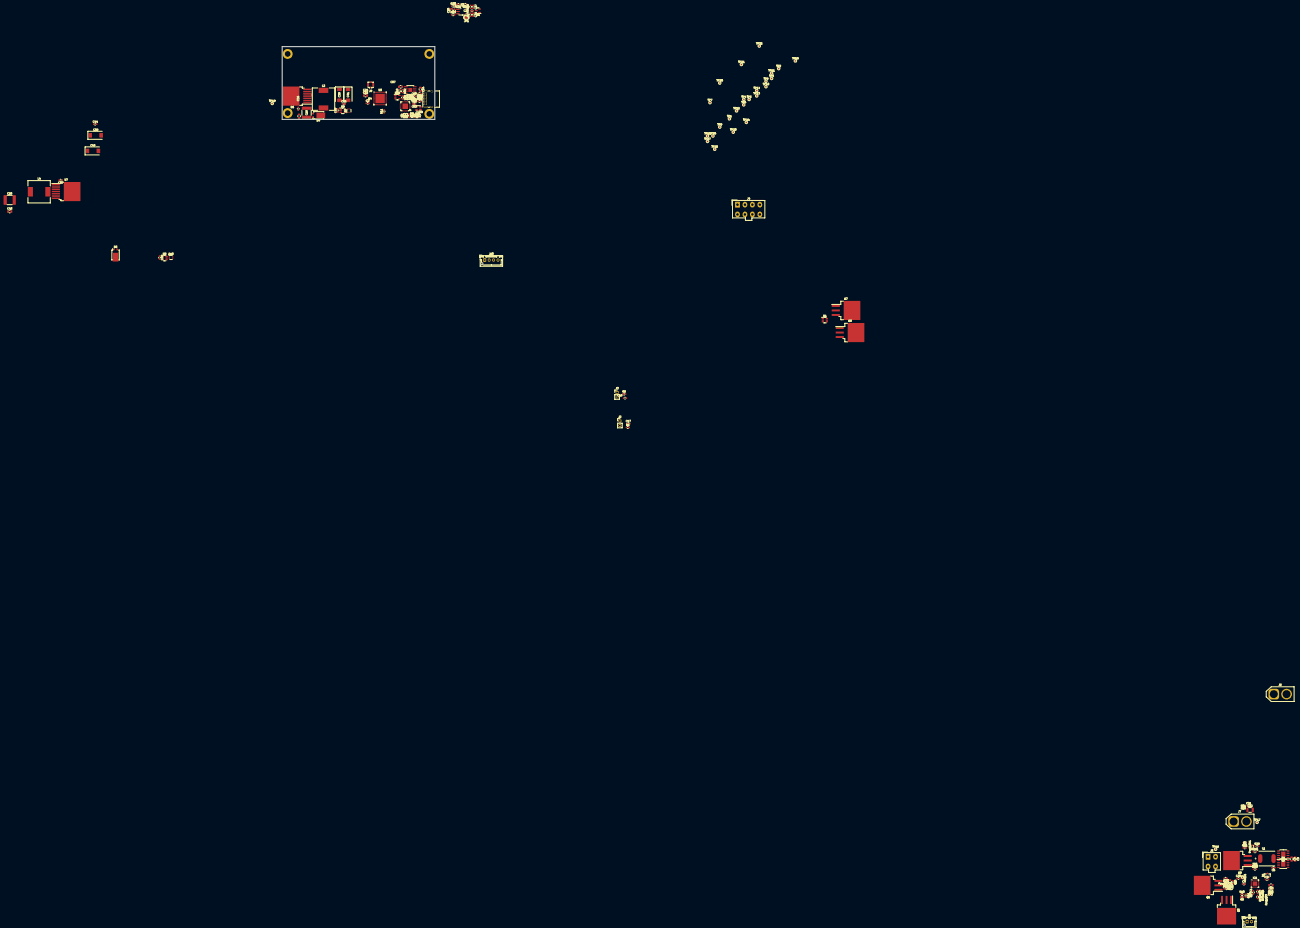
[picture p14: board powerboard_sc21_as25.kicad_pcb from above]

Board: 4 copper layers, 86.0 x 41.0 mm, 172 parts (0 on the bottom side), 83 nets.
