icl-rocketry/Ricardo-ThrottleController/Actuators Board/needlevalvedcmotor.kicad_pcb

## KiCad design Actuators Board/needlevalvedcmotor.kicad_pcb (2021-12-11, last stored version)

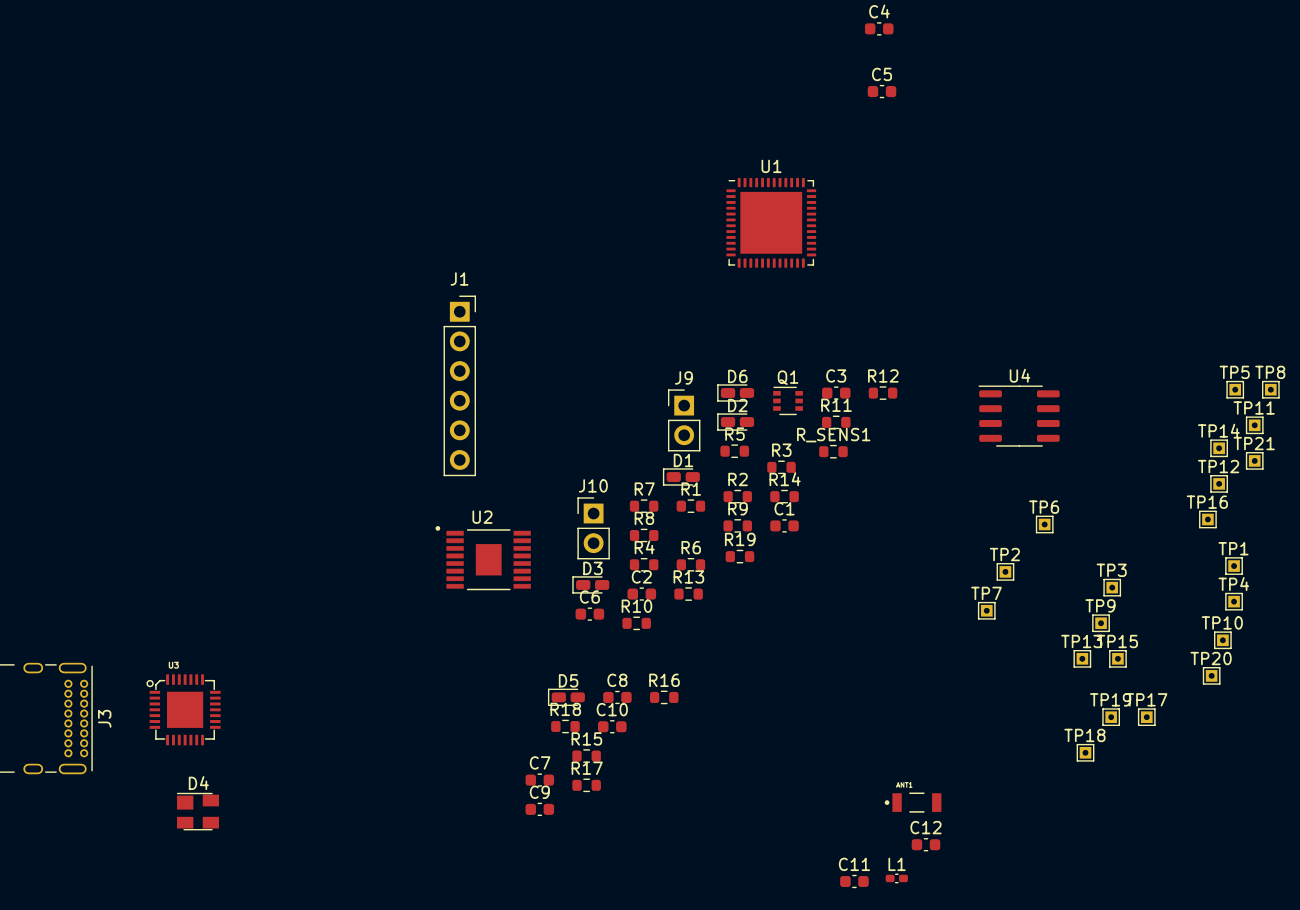
[picture p15: board needlevalvedcmotor.kicad_pcb from above]

Board: 2 copper layers, 70 parts (0 on the bottom side), 39 nets, no tracks yet.

Parts:
ANT1: AMCA31-2R450G-S1F-T3; ANT_AMCA31-2R450G-S1F-T3
C1, C2, C3, C4, C9, C10: 0.1uF; C_0603_1608Metric
C5: 10uF; C_0603_1608Metric
C6: 1uF; C_0603_1608Metric
C7: 4.7uF; C_0603_1608Metric
C8: 1.0uF; C_0603_1608Metric
C11: 1.2pF; C_0603_1608Metric
C12: 1.5pF; C_0603_1608Metric
D1: 24V LED; LED_0603_1608Metric_Castellated
D2: RX_LED; LED_0603_1608Metric_Castellated
D3: TX_LED; LED_0603_1608Metric_Castellated
D4: SP0503BAHT; SOT-143
D5: USB_LED; LED_0603_1608Metric_Castellated
D6: 3.3V LED; LED_0603_1608Metric_Castellated
J1: Conn_01x06_Male; PinSocket_1x06_P2.54mm_Vertical
J3: USB_C_Receptacle_USB2.0; USB_C_Receptacle_GCT_USB4085
J9, J10: Conn_01x02_Male; PinHeader_1x02_P2.54mm_Vertical
L1: LQG15WZ1N8B02D; L_0402_1005Metric_Pad0.77x0.64mm_HandSolder
Q1: MMDT2222A; SOT-363_SC-70-6
R1, R2, R7, R8: 10K; R_0603_1608Metric
R3, R4, R5, R9, R10, R11, R14, R18: 470; R_0603_1608Metric
R6, R12: 1k; R_0603_1608Metric
R13: 10k; R_0603_1608Metric
R15, R16: 5.1k; R_0603_1608Metric
R17: 4.7k; R_0603_1608Metric
R19: 1.1k; R_0603_1608Metric
R_SENS1: 0.1; R_0603_1608Metric
TP1, TP2, TP3, TP4, TP5, TP6, TP7, TP8, TP9, TP10, TP11, TP12, TP13, TP14, TP15, TP16, TP17, TP18, TP19, TP20, TP21: TestPoint; TestPoint_THTPad_1.0x1.0mm_Drill0.5mm
U1: ESP32-PICO-D4; QFN-48-1EP_7x7mm_P0.5mm_EP5.3x5.3mm
U2: MAX14871EUE+; SOP65P637X110-16N
U3: INTERFACE-CP2102-GMR(QFN28); QFN28G_0.5-5X5MM
U4: SN65HVD230; SOIC-8_3.9x4.9mm_P1.27mm

Connections:
+3V3: C4.1, C5.1, C7.2, C9.2, J1.4, R7.1, R8.1, R10.1, R11.1, R13.1, R14.2, R17.1, U2.8, U3.6, U4.3
+24V: C6.1, R12.2, U2.4, U2.13
/BOOT: Q1.3, R8.2, R9.1, TP9.1, U1.23
/CAN_HIGH: TP6.1, U4.7
/CAN_LOW: TP7.1, U4.6
/CAN_RX: TP20.1, U1.13, U4.4
/CAN_TX: TP21.1, U1.12, U4.1
/COMM: R_SENS1.1, U2.1, U2.5, U2.16
/DTR: Q1.4, R1.2, TP4.1, U3.28
/EN: C2.1, Q1.6, R5.1, R7.2, TP5.1, U1.9
/FAULT: R13.2, TP15.1, TP16.1, U1.35, U2.10
/Hall1: J1.5, TP13.1, U1.34
/Hall2: J1.6, TP12.1, U1.24
/LNA_IN: C11.1, L1.1, TP8.1, U1.2
/Motor+: J1.1, U2.2, U2.3
/Motor-: J1.2, U2.14, U2.15
/PWM: TP14.1, U1.18, U2.6
/RTS: Q1.1, R2.2, TP1.1, U3.24
/RXD: D2.1, TP2.1, TP10.1, U1.41, U3.25
/TXD: D3.1, TP3.1, TP11.1, U1.40, U3.26
/USB -> UART/Data+: D4.4, J3.A6, J3.B6, TP18.1, U3.4
/USB -> UART/Data-: D4.3, J3.A7, J3.B7, TP17.1, U3.5
GND: C1.2, C2.2, C3.2, C4.2, C5.2, C6.2, C7.1, C8.1, C9.1, C10.1, C11.2, C12.2, D1.1, D4.1, D5.1, D6.1, J1.3, J3.A1, J3.A12, J3.B1, J3.B12, J3.S1, J9.2, J10.2, R3.2, R4.1, R4.2, R6.1, R15.2, R16.1, R19.2, R_SENS1.2, U1.1, U1.3, U1.4, U1.19, U1.37, U1.43, U1.46, U1.49, U2.11, U2.17, U3.3, U4.2, U4.8
unnamed: ANT1.1, C12.1, L1.2
unnamed: C1.1, J9.1, R5.2
unnamed: C3.1, J10.1, R9.2
unnamed: D1.2, R3.1
unnamed: D2.2, R10.2
unnamed: D3.2, R11.2
unnamed: D5.2, R18.2
unnamed: D6.2, R14.1
unnamed: J3.A5, R15.1
unnamed: J3.B5, R16.2
unnamed: Q1.2, R1.1
unnamed: Q1.5, R2.1
unnamed: R6.2, R12.1
unnamed: R17.2, U3.9
unnamed: R19.1, U2.12
VBUS: C8.2, C10.2, D4.2, J3.A4, J3.A9, J3.B4, J3.B9, R18.1, TP19.1, U3.7, U3.8
