icl-rocketry/Ricardo-ThrottleController/(commit log)

2021-11-06 Add files via upload
    Ricardo Mainboard but (mostly) without the stuff the actuators board doesn't need. ESP32 still needs changing to ESP32Pico, more stuff may need deleting.
    [Mainboard.sch, power.sch]
2021-11-06 actually this time
    [Mainboard.sch]
2021-11-09 usbc completed and autoboot fixed
    [Mainboard.sch, power.sch]
2021-11-09 (hopefully) last unnecessary nets removed
    [Mainboard.sch]
2021-11-09 pico swap done
    [Mainboard.sch]
2021-11-12 Added blank sheets for the different actuator types
    Servos, Needledc and Solenoids to be filled in later with components for control and power
    [Mainboard.sch, needledc.sch, power.sch, servos.sch, solenoids.sch]
2021-11-13 Restructured files for easier board duplication
    Having one board as a template and most sub-components(i.e. not the microcontroller) in hierarchical sheets makes it easy to propagate a change to all boards instead of having to manually add the change in. The restructure is not fully complete
    [Mainboard.sch, board_template.sch, needledc.sch, power.sch, servos.sch, solenoids.sch, usb-uart.sch]
2021-11-16 Moved CAN into a separate sheet
    [can.sch]
2021-11-16 Made copies of board
    [ServoBoard.sch, SolenoidBoard.sch]
2021-11-16 Added servo, some connections done
    Add decoupling capacitors to VIN
    [usb-uart.sch]
2021-11-16 mostly connected H-bridge
    [needlevalvedcmotor.sch, usb-uart.sch]
2021-11-20 Added H-bridge and connector connections
    [needlevalvedcmotor.sch]
2021-11-20 CP2102 added and some connections
    On the usb-uart board
    [usb-uart.sch]
2021-11-20 Finished buck converter schematic, connected servo
    [ServoBoard.sch]
2021-11-27 Added Rf antenna to all boards
    [ServoBoard.sch, SolenoidBoard.sch, board_template.sch, needlevalvedcmotor.sch, rfantenna.sch, usb-uart.sch]
2021-11-27 Finished CP2102 connections
    On Usb/Uart board
    [usb-uart.sch]
2021-11-27 Changed capacitance for decoupling cap
    [needlevalvedcmotor.sch]
2021-11-27 Preliminary design of solenoid board
    [can.sch, usb-uart.sch]
2021-11-30 Place Hierarchical Pins from CAN sheet to each board.
    [ServoBoard.sch, SolenoidBoard.sch, board_template.sch, can.sch, needlevalvedcmotor.sch]
2021-11-30 Connected 3.3V to ESP32 according to schematic
    [ServoBoard.sch, SolenoidBoard.sch, board_template.sch, needlevalvedcmotor.sch]
2021-11-30 fixed CP2102 connections
    added polarised capacitors, deleted old CP and added hierarchical pin
    [usb-uart.sch]
2021-11-30 Connected 3.3V output from USB-UART converter
    [ServoBoard.sch, SolenoidBoard.sch, board_template.sch, needlevalvedcmotor.sch]
2021-12-04 Swapped IRF620 mosfet with SIJA74DP-T1-GE3
    [SolenoidBoard.sch]
2021-12-04 Added Data+, Data- and VBUS test points
    [usb-uart.sch]
2021-12-04 Connected H bridge PWM pin to ESP32
    [needlevalvedcmotor.sch]
2021-12-07 Hopefully swapped the mosfet for the last time
    [SolenoidBoard.sch]
2021-12-07 Hopefully swapped the mosfet for the last time
    new mosfet footprint: SOT-23
    [SolenoidBoard.sch]
2021-12-07 added test points on servo board
    [ServoBoard.sch, usb-uart.sch]
2021-12-07 Added test points to needle valve motor board
    [needlevalvedcmotor.sch]
2021-12-07 added test points and power connectors (solenoid)
    [SolenoidBoard.sch]
2021-12-07 Added connector to CAN sheet
    [can.sch]
2021-12-07 Added power connectors for needlevalve
    [can.sch, needlevalvedcmotor.sch]
2021-12-07 power connectors (servo)
    [ServoBoard.sch]
2021-12-07 Fixed power connections (servo)
    [ServoBoard.sch]
2021-12-07 Changed main connector to 5 pins, added cool LEDs (needlevalveboard)
    [can.sch, needlevalvedcmotor.sch, usb-uart.sch]
2021-12-07 Added main connector, CAN hierarchical pins and changed LEDs on template
    [board_template.sch]
2021-12-07 Diodes and power connections (solenoid)
    [SolenoidBoard.sch]
2021-12-07 Fixed LED (solenoid)
    [SolenoidBoard.sch]
2021-12-11 Connected H-Bridge Fault pin
    [needlevalvedcmotor.sch]
2021-12-11 servo sclk, miso and mosi pins removed
    [ServoBoard.sch]
2021-12-11 Removed unused nets on solenoid board
    [SolenoidBoard.sch]
2021-12-11 Added pull-up resistor to FAULT pin
    [needlevalvedcmotor.sch]
2021-12-11 CAN hierarchical pins added and tps
    [SolenoidBoard.sch]
2021-12-11 24V LED and CAN pins added (plus tp)
    [ServoBoard.sch]
2021-12-11 Changed sheet title in title card for all boards
    [ServoBoard.sch, SolenoidBoard.sch, needlevalvedcmotor.sch]
2021-12-11 Most footprint assignments on dc motor board
    [can.sch, needlevalvedcmotor.sch, rfantenna.sch, usb-uart.sch]
2021-12-11 More footprint assignments, imported components into PCB
    [needlevalvedcmotor.kicad_pcb, needlevalvedcmotor.sch, usb-uart.sch]
2021-12-11 Updated footprint for C7, grouped USB components together
    [usb-uart.sch]
2021-12-11 Revert "Servo labels and some footprint assignment"
    This reverts commit 6669555e32b9d4bf28a378e1f5bbeb85d7de6761.
2021-12-18 Combined the 3 boards into one
    [Actuators Board.sch, usb-uart.sch]
2021-12-18 Assigned footprints, changed sense resistor value, added diode to UART
    Sense resistor on the buck converter changed from 1.5K to 1.54K to more closely match 6V. Also added a diode on the 3.3V output on the USB-UART converter.
    [Actuators Board.sch, ServoBoard.sch, needlevalvedcmotor.kicad_pcb, usb-uart.sch]
2021-12-29 Connected H bridge direction select pin to esp32(I forgor)
    [Actuators Board.sch, needlevalvedcmotor.sch]
2022-01-01 Changed Pico EN capacitor to 1 uF (spotted in the datasheet)
    [Actuators Board.sch]
2022-01-22 copies of board made and some fps assigned
    [Actuators Board - Copy.kicad_sch, Actuators Board - Copy.sch, can.kicad_sch, rfantenna.kicad_sch, usb-uart.kicad_sch]
2022-01-22 Change R_SNS, initial draft of PCB layout
    [Actuators Board.kicad_pcb, Actuators Board.kicad_sch, can.kicad_sch, rfantenna.kicad_sch, usb-uart.kicad_sch]
2022-01-22 Re-converted some schematics to kicad6 to fix import issues
    [can.kicad_sch, rfantenna.kicad_sch, usb-uart.kicad_sch]
2022-01-25 Preliminary layout of buck converter components
    [Actuators Board.kicad_pcb, Actuators Board.kicad_sch, usb-uart.kicad_sch]
2022-01-25 changed buck converter inductor & diode to smaller footprints
    [Actuators Board.kicad_pcb, Actuators Board.kicad_sch]
2022-01-29 Preliminary layout of buck converter & supporting components
    [Actuators Board.kicad_pcb, Actuators Board.kicad_sch]
2022-01-29 autoboot circuit layout
    [Actuators Board.kicad_pcb, Actuators Board.kicad_sch, rfantenna.kicad_sch]
2022-01-29 Usb layout copy
    [Actuators Board - Copy.kicad_pcb]
2022-01-29 led stuff
    [Actuators Board.kicad_pcb]
2022-02-01 Swapped h-bridge with new one, combined the PCBs and some layout
    [Actuators Board.kicad_pcb, Actuators Board.kicad_sch]
2022-02-01 LED stuff simplification
    [Actuators Board.kicad_pcb]
2022-02-01 Fully connected autoboot circuit and jumpers.
    [Actuators Board.kicad_pcb, Actuators Board.kicad_sch]
2022-02-01 Fixed github's merge attempt
    [Actuators Board.kicad_pcb]
2022-02-01 Changed schottky diode name
    [Actuators Board.kicad_sch]
2022-02-01 Changed usb layout
    [Actuators Board.kicad_pcb]
2022-02-05 Reconfigured uart converter to disable 5->3.3V regulation
    [Actuators Board.kicad_sch, usb-uart.kicad_sch]
2022-02-05 Added LDO for 5 -> 3.3V
    [Actuators Board.kicad_sch, usb-uart.kicad_sch]
2022-02-05 Footprint assignments for capacitors+changed resistors on solenoid FET
    [Actuators Board.kicad_sch, usb-uart.kicad_sch]
2022-02-05 ideal diode added
    [Actuators Board.kicad_sch, usb-uart.kicad_sch]
2022-02-08 added ideal diode for 3.3V con
    [Actuators Board.kicad_sch]
2022-02-08 Manual merge of ideal diodes and footprint changes
    [Actuators Board.kicad_sch, usb-uart.kicad_sch]
2022-02-08 Annotated schematic and imported changes into PCB
    [Actuators Board.kicad_pcb, Actuators Board.kicad_sch, usb-uart.kicad_sch]
2022-02-08 copied files and fixed usb
    [Actuators Board - Copy.kicad_pcb, Actuators Board - Copy.kicad_sch, Actuators Board - Copy.sch]
2022-02-12 H bridge & CAN Transceiver final placement
    [Actuators Board.kicad_pcb, Actuators Board.kicad_sch]
2022-02-12 Deleted outdated / temporary schematics
    [ServoBoard.sch, SolenoidBoard.sch, board_template.sch, needlevalvedcmotor.sch]
2022-02-14 Removed more unnecessary files
    [Actuators Board.kicad_sch, Actuators Board.sch, can.sch, rfantenna.sch, usb-uart.sch]
2022-02-15 Finished usb
    [Actuators Board - Copy.kicad_pcb]
2022-02-15 solenoid tracked
    [Actuators Board - Copy.kicad_pcb]
2022-02-15 Buck converter placement & merged USB layout from 2nd board
    [Actuators Board.kicad_pcb]
2022-02-19 Swapped LDO to RT9025-25GSP & moved components closer together
    [Actuators Board.kicad_pcb, Actuators Board.kicad_sch, usb-uart.kicad_sch]
2022-02-22 condensed usb layout
    [Actuators Board.kicad_pcb]
2022-02-22 Rearranged buck converter to allow for datasheet ground areas
    [Actuators Board.kicad_pcb]
2022-02-22 Connected usb & uart to esp32
    [Actuators Board.kicad_pcb]
2022-02-22 Added mounting holes, initial placement inside 50x50 board
    [Actuators Board.kicad_pcb, Actuators Board.kicad_sch]
2022-02-25 Provisional layout of USB supporting components
    [Actuators Board.kicad_pcb]
2022-03-01 More USB connections, placement of 3.3V regulator
    [Actuators Board.kicad_pcb]
2022-03-01 SOL and U5 connections added
    copies of the files also made. Connections are about the bottom and U5 is at the right side.
    [Actuators Board - Copy.kicad_pcb, Actuators Board - Copy.kicad_sch]
2022-03-01 Added (unfilled) ground zones + antenna keepout
    [Actuators Board.kicad_pcb]
2022-03-05 LEDs connected and sol led moved
    [Actuators Board - Copy.kicad_pcb]
2022-03-05 Completed board layout
    [Actuators Board.kicad_pcb, Actuators Board.kicad_sch]
2022-03-08 Moved esp closer to the antenna
    [Actuators Board.kicad_pcb, Actuators Board.kicad_sch]
2022-03-08 most of board copy sorted
    [Actuators Board - Copy.kicad_pcb, Actuators Board - Copy.kicad_sch]
2022-03-08 redone layout to match new esp position
    [Actuators Board.kicad_pcb, Actuators Board.kicad_sch]
2022-03-08 Changed thermal vias on buck converter
    [Actuators Board.kicad_pcb, Actuators Board.kicad_sch]
2022-03-09 added gnd vias for esp32
    [Actuators Board.kicad_pcb]
2022-03-12 Added schematic for CAN transceiver passives; Deleted unused files
    Values still need to be assigned
    [Actuators Board - Copy.kicad_pcb, Actuators Board - Copy.kicad_sch, Actuators Board.kicad_sch, can.kicad_sch]
2022-03-15 Assigned values to CAN passives, connected SSR GPIO
    [Actuators Board.kicad_sch, can.kicad_sch]
2022-03-15 gnd vias for c25,c30,c18,c31 and ic1
    trace for ic1
    [Actuators Board - Copy.kicad_pcb]
2022-03-15 Added solder jumpers and resistors for SSR pull-up and pull-down.
    Also footprint assignment
    [Actuators Board.kicad_sch, can.kicad_sch]
2022-03-15 Added solder jumper for CAN Vref
    [Actuators Board.kicad_sch, can.kicad_sch]
2022-03-18 Swapped RBUS connector, layout needs update.
    [Actuators Board.kicad_pcb, Actuators Board.kicad_sch, can.kicad_sch]
2022-03-22 SSR connector layout done in copy
    copies made and moved pin for SSRGPIO in the schematic
    [Actuators Board - Copy.kicad_pcb, Actuators Board - Copy.kicad_sch]
2022-03-22 Added CAN transceiver and new connector to board
    [Actuators Board.kicad_pcb, Actuators Board.kicad_sch, can.kicad_sch, usb-uart.kicad_sch]
2022-03-22 Converted pcb into 4 layers and fixed schematic merge issues
    [Actuators Board.kicad_pcb, Actuators Board.kicad_sch]
2022-03-25 Changed connectors
    [Actuators Board.kicad_pcb, Actuators Board.kicad_sch]
2022-03-25 Finished Board Layout
    [Actuators Board.kicad_pcb, Actuators Board.kicad_sch]
2022-03-26 Swapped SSR pad for connector
    [Actuators Board.kicad_pcb, Actuators Board.kicad_sch]
2022-03-27 Fixed front silkscreen (references) and added ICLR logo + designer names
    [Actuators Board.kicad_pcb, Actuators Board.kicad_sch]
2022-03-28 Added board name and picture, rerouted USB traces
    [Actuators Board.kicad_pcb]
2022-03-28 Cut down on the number of vias, changed folder structure
    [Actuators Board - Copy.kicad_pcb, Actuators Board - Copy.kicad_sch, Actuators Board.kicad_pcb, Actuators Board.kicad_sch, can.kicad_sch, rfantenna.kicad_sch, usb-uart.kicad_sch]
2022-03-28 changed autoprogrammer cap values
    [Actuators Board.kicad_sch]
2022-03-31 changed boot and EN jumper Caps
    [Actuators Board.kicad_sch]
2022-04-05 Implemented design review feedback
    [Actuators Board.kicad_pcb, Actuators Board.kicad_sch, rfantenna.kicad_sch, usb-uart.kicad_sch]
2022-04-05 Reduced thermal relief for the higher current connectors
    [Actuators Board.kicad_pcb]
2022-04-09 Changed LDO footprint to include exposed pad
    [Actuators Board.kicad_pcb, Actuators Board.kicad_sch, usb-uart.kicad_sch]
2022-05-12 change resistor values for new LDO
    [Actuators Board.kicad_pcb, Actuators Board.kicad_sch, usb-uart.kicad_sch]
2022-07-02 fixing tiny mistake in schem, this is just backup
    [battchrg.kicad_sch, powerboard_sc21_as25.kicad_pcb, powerboard_sc21_as25.kicad_sch, redundantreg.kicad_sch, usb__uart.kicad_sch]
2022-07-02 Revert "fixing tiny mistake in schem, this is just backup"
    This reverts commit 2ead116df8802abab2d6772e4dbb16b79d5141ca.
    [battchrg.kicad_sch, powerboard_sc21_as25.kicad_pcb, powerboard_sc21_as25.kicad_sch, redundantreg.kicad_sch, usb__uart.kicad_sch]
2022-07-12 Chad V2
    [Actuators Board.kicad_pcb, Actuators Board.kicad_sch, can.kicad_sch, usb-uart.kicad_sch]
2022-07-13 Added changelist and gerbers for v2
    [Actuators Board-B_Cu.gbr, Actuators Board-B_Mask.gbr, Actuators Board-B_Paste.gbr, Actuators Board-B_Silkscreen.gbr, Actuators Board-Edge_Cuts.gbr, Actuators Board-F_Cu.gbr, Actuators Board-F_Mask.gbr, Actuators Board-F_Paste.gbr]
2022-07-14 updated silkscreen, antenna line width and removed can resistors
    [Actuators Board-B_Cu.gbl, Actuators Board-B_Mask.gbs, Actuators Board-B_Paste.gbp, Actuators Board-B_Paste.gbr, Actuators Board-B_Silkscreen.gbo, Actuators Board-Edge_Cuts.gm1, Actuators Board-F_Cu.gtl, Actuators Board-F_Mask.gts]
2022-09-01 chad software
    [ricpart.csv]
2022-09-04 chad code with remote motor files
2022-10-05 added button interface for retraction motor
2022-11-01 changed file structure, mostly completed ESP32S3 schematics
    [Actuators Board-B_Cu.gbl, Actuators Board-B_Mask.gbs, Actuators Board-B_Paste.gbp, Actuators Board-B_Silkscreen.gbo, Actuators Board-Edge_Cuts.gm1, Actuators Board-F_Cu.gtl, Actuators Board-F_Mask.gts, Actuators Board-F_Paste.gtp]
2022-11-07 added jumper to change the buck converter to 8.4v
    [Chad.kicad_sch, can.kicad_sch, usb-uart.kicad_sch]
2022-12-12 End of V1
    [Actuators Board.kicad_pcb, Actuators Board.kicad_sch, Chad.kicad_pcb, Chad.kicad_sch, can.kicad_sch, usb-uart.kicad_sch]
2022-12-22 mostly completed v2 schematic (pin assignments left)
    [Actuators Board.kicad_pcb, Actuators Board.kicad_sch, Chad.kicad_pcb, Chad.kicad_sch, buckC.kicad_sch, can.kicad_sch, power.kicad_sch, rfantenna.kicad_sch]
2023-01-13 initial layout for rough sizing
    [Chad.kicad_pcb, buckC.kicad_sch]
2023-02-01 Mostly completed RBUS side, still buck converter side to do
    [Chad.kicad_pcb, Chad.kicad_sch, can.kicad_sch, usb-uart.kicad_sch]
2023-02-10 new USB port, added 3d models for the taller connectors
    [Chad.kicad_pcb, Chad.kicad_sch, usb-uart.kicad_sch]
2023-02-16 on the verge of being complete, also updated to kicad 7
    [Chad.kicad_pcb, Chad.kicad_sch, buckC.kicad_sch, can.kicad_sch, power.kicad_sch, usb-uart.kicad_sch]
2023-02-18 all the important stuff routed, only back gfx and via stitch left
    [Chad.kicad_pcb, Chad.kicad_sch, can.kicad_sch]
2023-02-18 added DNP capacitors, via fencing. still left: reduce number of vias
    [Chad.kicad_pcb, buckC.kicad_sch]
2023-02-21 fixed via numbers, added gpio pullup option, need to decide PGood flag
    [Chad.kicad_pcb, Chad.kicad_sch, buckC.kicad_sch]
2023-02-23 v2 finished? (pre-review)
    [Chad.kicad_pcb, Chad.kicad_sch, buckC.kicad_sch]
2023-02-24 last commit is a lie, made some small changes
    [Chad.kicad_pcb]
2023-02-24 small silkscreen tweaks
    [Chad.kicad_pcb]
2023-02-25 better ICLR logo, 3d model exports with edge connectors
    [Chad.kicad_pcb, Chad.kicad_sch, Chad.step]
2023-02-27 updated to use 12A inductor
    [Chad.kicad_pcb]
2023-02-28 updated current limit resistor (oops)
    [Chad.kicad_pcb, buckC.kicad_sch]
2023-02-28 forgot to stage
2023-03-08 jlc order number location specified, slightly better can routing
    [Chad.kicad_pcb]
2023-03-09 changed some caps, added gerbers and bom
    [Chad-B_Cu.gbl, Chad-B_Mask.gbs, Chad-B_Paste.gbp, Chad-B_Silkscreen.gbo, Chad-Edge_Cuts.gm1, Chad-F_Cu.gtl, Chad-F_Mask.gts, Chad-F_Paste.gtp]
2023-03-14 Added buck hat to chad logo, needs some tweaks
    [Chad.kicad_pcb]
2023-03-15 Changed bucket hat chad slightly, moved some vias around
    [Chad-B_Cu.gbl, Chad-B_Mask.gbs, Chad-B_Paste.gbp, Chad-B_Silkscreen.gbo, Chad-Edge_Cuts.gm1, Chad-F_Cu.gtl, Chad-F_Mask.gts, Chad-F_Paste.gtp]
2023-06-05 review changes + some new features
    [Chad-B_Cu.gbl, Chad-B_Mask.gbs, Chad-B_Paste.gbp, Chad-B_Silkscreen.gbo, Chad-Edge_Cuts.gm1, Chad-F_Cu.gtl, Chad-F_Mask.gts, Chad-F_Paste.gtp]
2023-06-05 ok well apparently I didn't hit save on the pcb
    [Chad.kicad_pcb]
2023-06-12 took out the can caps
    [Chad.kicad_pcb, can.kicad_sch]
2023-06-12 Forgot to regen gerbers
    [Chad-B_Cu.gbl, Chad-B_Mask.gbs, Chad-B_Paste.gbp, Chad-B_Silkscreen.gbo, Chad-Edge_Cuts.gm1, Chad-F_Cu.gtl, Chad-F_Mask.gts, Chad-F_Paste.gtp]
2023-06-29 cleaning up
    [Chad.kicad_pcb]
2023-06-29 nvm forgot teardrops
    [Chad.kicad_pcb]
2023-07-07 changed inductor to one that won't heat up as much
    [Chad.kicad_pcb, buckC.kicad_sch]
2023-07-07 crystal and caps
    [Chad.kicad_sch]
2023-07-07 teardrops :)
    [Chad.kicad_pcb]
2023-07-09 gnd keepout
    [Chad.kicad_pcb]
2023-07-09 accidentally messed up some references apparently?
    [Chad.kicad_pcb]
2023-07-14 production files
    [Chad-B_Cu.gbl, Chad-B_Mask.gbs, Chad-B_Paste.gbp, Chad-B_Silkscreen.gbo, Chad-Edge_Cuts.gm1, Chad-F_Cu.gtl, Chad-F_Mask.gts, Chad-F_Paste.gtp]
2023-07-24 finished buck class, need to add commands to actually interact with it
2023-07-26 Added commands to retrieve servo voltage and to restart buck
2023-08-01 renamed software to firmware
    [ricpart.csv]
2023-08-08 intialised can interface, enabled buck restart command, checked out ...
    ... correct branches for the submodules
    [system.cpp, system.h]
2023-08-30 Compiles, buck voltage reading needs to be fixed/implemented
    [system.cpp]
2023-08-30 engine controller folder added
    [ricpart.csv]
2023-09-17 fixes + cold flow setup
    [ricpart.csv]
2023-09-28 ugh case sensitive issues
2023-09-30 CAN update pulled, calibration, artem disarm and shutdown update
2023-09-30 thanos default changed to full blip, pressure services reconfigured
2024-02-09 Fuel servo now tracks ox servo by percent and not absolute
2024-02-10 reimplemented chamber pressure val update
2024-02-20 added csv with controller params
    [NRCThanos_params.csv]
2024-06-13 changed ignition sequence to go directly to feedforward chamber pressure, fixed (again) the bug causing max integrator at test start
    [nrcthanos.cpp, nrcthanos.h]
2024-06-14 Fixed issue where integral grew an order of magnitude slower than it was meant to
    [nrcthanos.cpp]
2024-07-13 Repo cleanup
    [Chad.kicad_pcb, Chad.kicad_sch, Chad.step, bom.csv, buckC.kicad_sch, can.kicad_sch, designators.csv, positions.csv]
